BrandenConnors/it-dept-pumpkin-cart/Parts/02_Chassis_Mounts/README.md

# 02 Chassis Mounts

Use the master [build guide](../../Documentation/Build_Guide.pdf). STL files use millimeters and retain their supplied print orientations. One STL is one piece; print the quantities below.

| STL | Quantity | Status |
|---|---:|---|
| 16A_front_end_adapter_TRIAL.stl | As needed | Optional alternative |
| 16B_rear_end_adapter_TRIAL.stl | 1 | As fitted |
| 17_mount_shim_12mm_print_4.stl | 4 | As fitted |
| 17B_mount_shim_2mm_OPTIONAL.stl | As needed | As fitted |

## Fit and printing notes

- **16A_front_end_adapter_TRIAL.stl:** Front adapter omitted in Branden's assembled configuration. Retained as an alternate mount option.
- **16B_rear_end_adapter_TRIAL.stl:** Retain your successful spacer stack and mounting configuration. 8 mm trial adapter; rear chassis slots nominal 86 mm centers. Fit template 00D first. Chassis screw thread/length not yet confirmed.
- **17_mount_shim_12mm_print_4.stl:** Retain your successful spacer stack and mounting configuration. 12 mm provisional spacer between adapter and floor underside. Adjust height only after checking clearances under load.
- **17B_mount_shim_2mm_OPTIONAL.stl:** Retain your successful spacer stack and mounting configuration. Optional 2 mm adjustment washer. Print only as required; use equal stacks left/right. Longer bolts may be needed.
