BrandenConnors/it-dept-pumpkin-cart/Stencils/Pumpkin_Cutting_Stencils.pdf

IT DEPT PUMPKIN CART / CURRENT STENCILS

# Pumpkin pieces: complete cutting set

Release 1.0.0 | R2 bed/roof + HF2 hood/fenders + SR1 side runners

Print pages 2-8 at 100%, then fit paper to the assembled cart first.
Trace on the inner flesh face. Begin with 8-10 mm or more at spike contacts. The 6 mm spikes must engage flesh without breaking through the outer rind. Do not press pumpkin on until fasteners are tightened and clearances checked.
2 | Bed sides | x2 | 132 x 47.6 mm
3 | Rear bed | x1 | 154 x 47.6 mm; trim to side thickness
4 | Roof | x1 | 158 x 168.4 mm developed surface
5 | Cab skirts | x2 | 120 x 34 mm; reverse for other side
6 | Rear wheel arches | x2 | 116 x 55 mm, R44 opening
7 | Front fenders | x2 | 100 x 34 mm contact footprints
8 | Hollow hood | x1 | Fitting reference; exterior hand-trimmed

Fit bed sides, rear panel, skirts and arches, then hood/fenders; roof last. For a one-piece hood plus fenders, use page 7 to mark the two pad contacts on your shell. Their spacing depends on your final slider settings.
Page 8 deliberately does not prescribe a 30 mm-high cap or fixed cavity.
The old low-hood template is superseded and is not included.
Check the complete tire sweep with the pumpkin fitted, then test at low speed.

Print Actual Size / 100%. Never Fit or Shrink. Verify the ruler.

0 | 10 | 20 | 30 | 40 | 50 | 60 | 70 | 80 | 90 | 100
100 mm calibration ruler. Crosses mark flesh contact; do not drill holes.
IT DEPT PUMPKIN CART / CURRENT STENCILS | 1 / 8

## A + B / Bed side panels

For the R2 50 mm-tall bed. Spike marks face the PLA wall.

IT DEPT PUMPKIN CART / R2 | 2 / 5

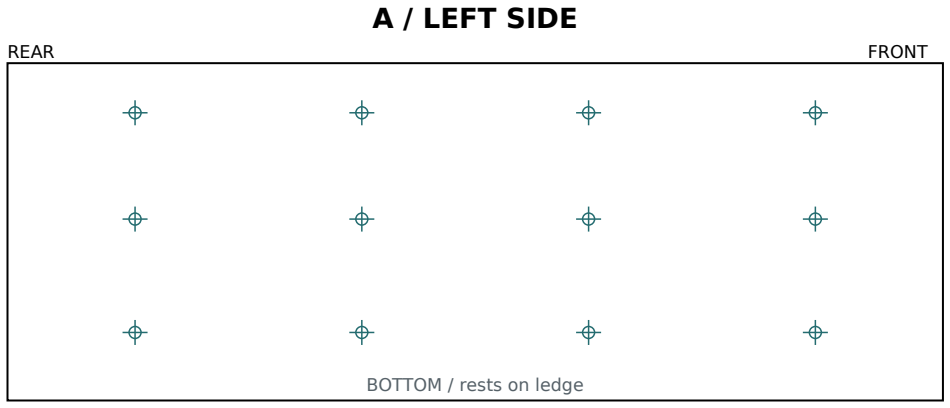
[picture p2: figure]
A / LEFT SIDE; REAR; FRONT; BOTTOM / rests on ledge

132 x 47.6 mm - cut 1

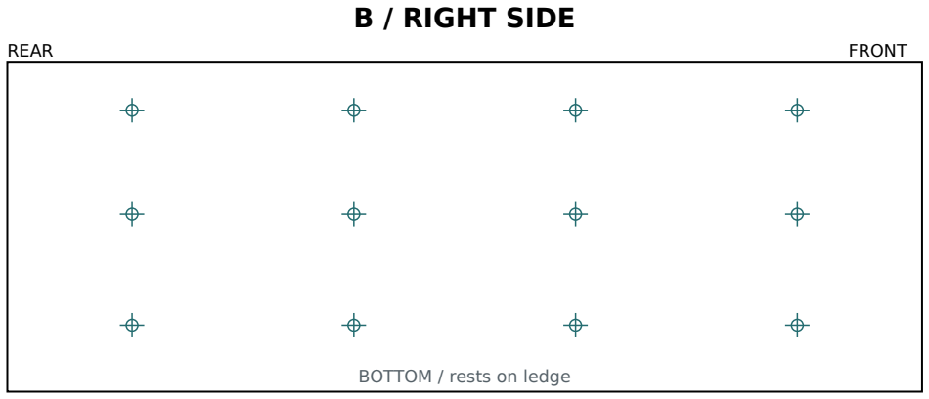
[picture p3: figure]
B / RIGHT SIDE; REAR; FRONT; BOTTOM / rests on ledge

132 x 47.6 mm - cut 1

Cut one of each. Both sides use the same outline and spike pattern.

The 47.6 mm height runs from the ledge top to the 50 mm bed rim.

Mark the flesh face only. Press onto spikes without pre-punching holes.

Trim the ends locally if the curved bed corners prevent a close fit.

PRINT ACTUAL SIZE / 100% | US LETTER | Do not use Fit or Shrink.

Millimeters: verify 0-100 measures exactly 100 mm.

1 inch wide

Solid = cut edge. Cross = spike contact mark; do not punch holes.

IT DEPT PUMPKIN CART / CURRENT STENCILS | 2 / 8

## C / Rear bed panel

Cut oversize for 10 mm side panels, then trim after fitting the sides.

IT DEPT PUMPKIN CART / R2 | 3 / 5

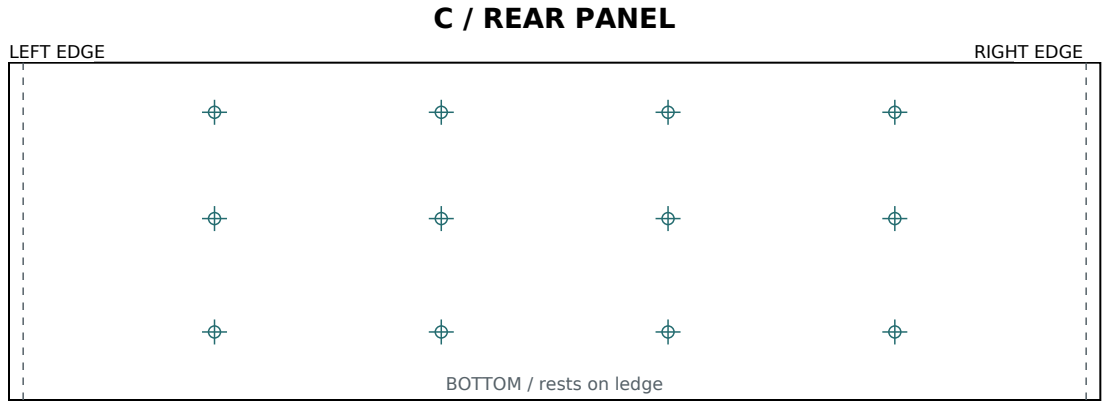
[picture p4: figure]
C / REAR PANEL; REAR; FRONT; BOTTOM / rests on ledge; LEFT EDGE; RIGHT EDGE

154 x 47.6 mm - cut 1

The rear panel covers the exposed ends of the two side panels.

Starting width = 134 mm bed width + twice your side-panel thickness.

Keep the rear panel centered so its spike marks remain aligned.

Side-panel thickness | Rear width | Trim from each edge
10 mm | 154 mm | 0 mm
9 mm | 152 mm | 1 mm
8 mm | 150 mm | 2 mm

Dashed lines show the 150 mm width for 8 mm side panels.

Use your fitted paper pattern to confirm the corner joints before carving.

PRINT ACTUAL SIZE / 100% | US LETTER | Do not use Fit or Shrink.

Millimeters: verify 0-100 measures exactly 100 mm.

1 inch wide

Solid = cut edge. Cross = spike contact mark; do not punch holes.

IT DEPT PUMPKIN CART / CURRENT STENCILS | 3 / 8

## D / Roof panel

Full-size unfolded contact surface. Crosses locate the 12 roof spikes.

IT DEPT PUMPKIN CART / R2 | 4 / 5

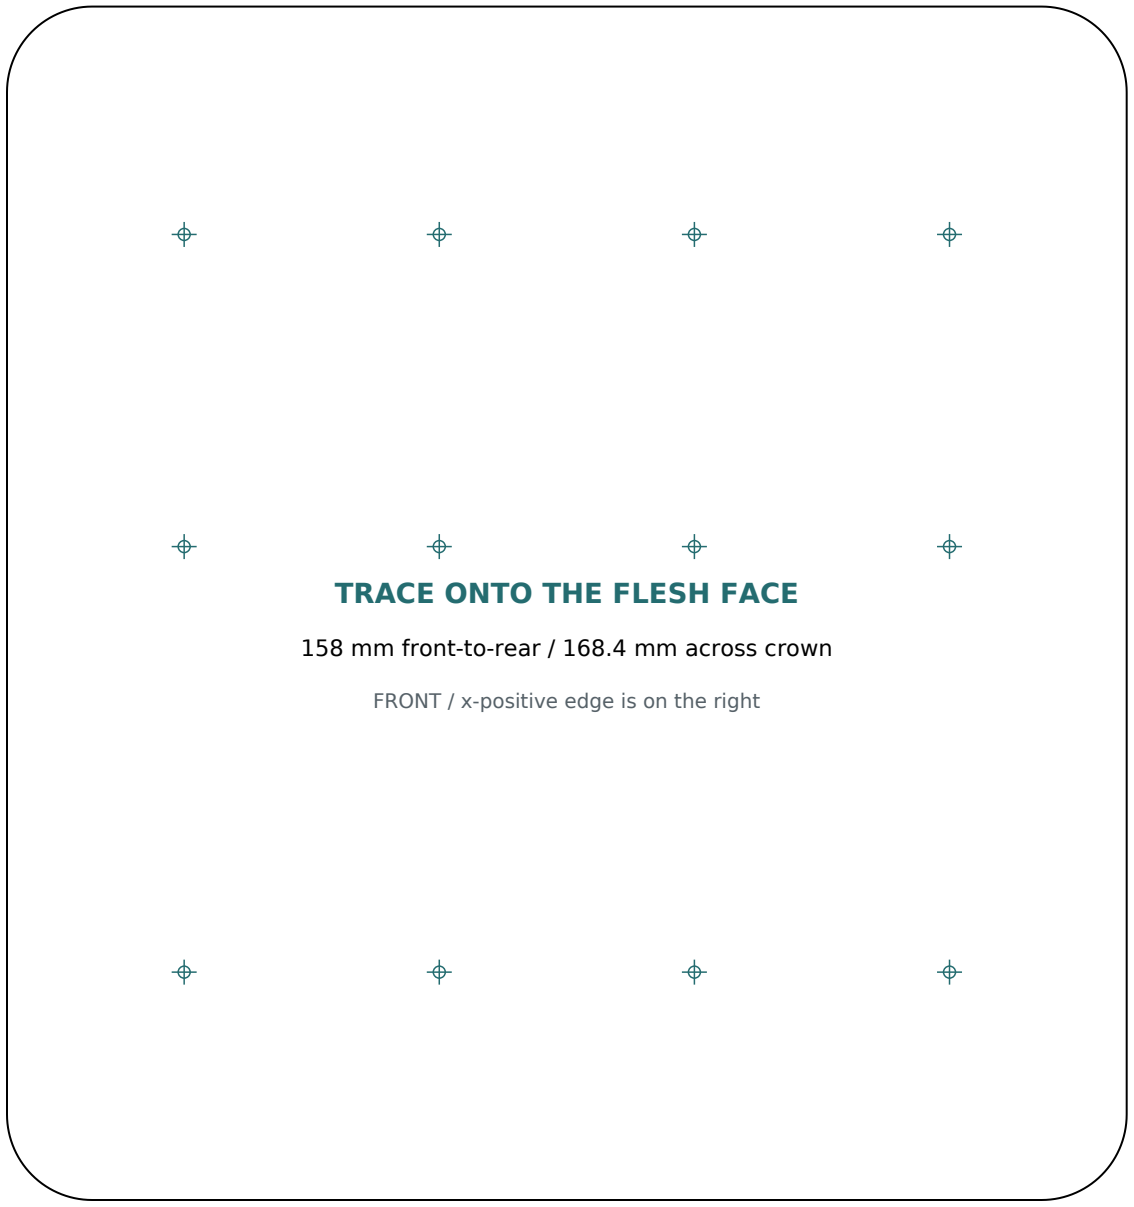
[picture p5: figure]
TRACE ONTO THE FLESH FACE; FRONT / x-positive edge is on the right

158 mm front-to-rear / 168.4 mm across crown

Fit across the shallow crown; the outline includes its curved surface length.

Keep the panel removable. Trim the paper outline first if your rind will not conform.

PRINT ACTUAL SIZE / 100% | US LETTER | Do not use Fit or Shrink.

Millimeters: verify 0-100 measures exactly 100 mm.

1 inch wide

Solid = cut edge. Cross = spike contact mark; do not punch holes.

IT DEPT PUMPKIN CART / CURRENT STENCILS | 4 / 8

IT DEPT PUMPKIN CART / SIDE RUNNERS SR1 | 5 / 6

# Cab pumpkin cutting template

Full size. Cut two pumpkin pieces; reverse the pattern for the opposite side.

REAR | FRONT

100 mm - print Actual Size / 100%, never Fit to Page

Solid outline is the backing footprint: 120 x 34 mm.

Red crosses mark spike locations. They are NOT drilled mounting holes.

Begin with roughly 8-10 mm of pumpkin flesh at the spike locations.

The spikes extend 6 mm into the flesh; thicker pieces can be used.

Rest the bottom edge on the ledge and press evenly onto the spikes.

Carve small access recesses over the panel screws if needed.

Trim the outside silhouette to blend into the adjoining rear arch.

Fit both pieces to the actual vehicle before making any extra overhang.

Prototype: verify actual wheel travel, pumpkin grip and clamp security before driving.

IT DEPT PUMPKIN CART / CURRENT STENCILS | 5 / 8

IT DEPT PUMPKIN CART / SIDE RUNNERS SR1 | 6 / 6

# Rear arch pumpkin cutting template

Full size. The wheel opening is provisional: check articulation before carving.

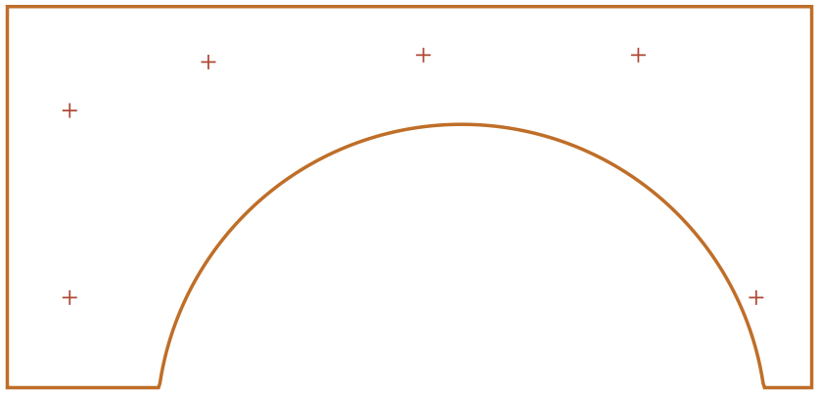
[picture p6: figure]

REAR | FRONT

100 mm - print Actual Size / 100%, never Fit to Page

Outline: 116 x 55 mm, with a 44 mm-radius opening centered 65.5 mm

from the rear edge and 6 mm below the bottom edge of the bounding box.

Cut two pumpkin pieces; reverse the pattern for the opposite side.

The ledges above the arch need shallow seating notches in the inner flesh.

Mark these directly from the printed panel before pressing onto the spikes.

Keep flesh clear of the whole tire sweep, not just the tire at rest.

If the backing itself touches a tire or linkage, do not drive the cart.

Readjust or revise the support first; carving pumpkin alone cannot fix that.

Prototype: verify actual wheel travel, pumpkin grip and clamp security before driving.

IT DEPT PUMPKIN CART / CURRENT STENCILS | 6 / 8

IT DEPT PUMPKIN CART / CURRENT STENCILS

# Front fenders / cut two

Full-size pad footprints. Use as contact patterns for a single hood/fender shell.

REAR / long end | FRONT
100 x 34 mm | six spike contacts | cut one
REAR / long end | FRONT
100 x 34 mm | six spike contacts | cut one

The outline matches the printed pad, not the final bodywork silhouette.
Round and trim each piece to blend with the hood and adjacent cab skirt. Seat the flesh on the pad before assessing tire clearance or adding overhang. Keep screw access available until both pad positions are final.
For one shell, transfer these marks after adjusting each pad to the shell.

Print Actual Size / 100%. Never Fit or Shrink. Verify the ruler.

100 mm calibration ruler. Crosses mark flesh contact; do not drill holes.

IT DEPT PUMPKIN CART / CURRENT STENCILS | 7 / 8

IT DEPT PUMPKIN CART / CURRENT STENCILS

# HF2 hood / full-size fitting reference

Top view: NOT a fixed exterior cut line. Match the hollow shell to the raised bars.

FRONT (+X) is to the RIGHT

Solid: 76 x 88 mm carrier reference. Dashed: 48 x 64 mm tower envelope.

Orange bars: six hood contact points. Their height adjusts independently. Seats adjust 40-60 mm above carrier bottom; spike tips are 46-66 mm above.
1. Fit paper around your hollow pumpkin shell; mark its desired outer silhouette.
2. Allow cavity clearance around the dashed envelope and all screw heads.
3. Lower bars; trial-fit shell. Raise seats to meet the inner flesh without forcing.
4. Remove shell, tighten sliders, then press onto the six spikes.
5. Join to separate fenders, or transfer pad contacts to your one-piece shell. Retain 8-10 mm or more of flesh at contacts. Carve gradually and recheck. A hollow shell is three-dimensional: this top view cannot define its final cut.

Print Actual Size / 100%. Never Fit or Shrink. Verify the ruler.

100 mm calibration ruler. Crosses mark flesh contact; do not drill holes.

IT DEPT PUMPKIN CART / CURRENT STENCILS | 8 / 8
