BrandenConnors/it-dept-pumpkin-cart/Documentation/GITHUB_PUBLISH_PLAN.md

# GitHub publication plan

Prepared repository name: `it-dept-pumpkin-cart` (proposed; not created).
Prepared first release/tag: `v1.0.0`.

1. Connect GitHub and choose the owning account or existing repository.
2. Begin with a private repository unless Branden chooses public visibility.
3. Put the CONTENTS of this package at repository root: README, Parts, Documentation, Stencils, Source, and inventories.
4. Review the README, source attribution and license choice before making the repository public. No license grant has been added automatically.
5. Commit the packaged files and tag the initial release `v1.0.0` after reviewing the repository.
6. Attach the complete ZIP to the GitHub release for convenient downloading; do not commit the ZIP inside the repository as a duplicate of all files.
7. Future physical changes should receive a new release, updated guide/stencils and a changelog describing what needs reprinting.

The package is ready for this upload. Packaging does not itself create a repository or publish any files. The archive contains project files, not user photographs or account credentials.
