BrandenConnors/it-dept-pumpkin-cart/Documentation/Images/hf2_insert_map.png

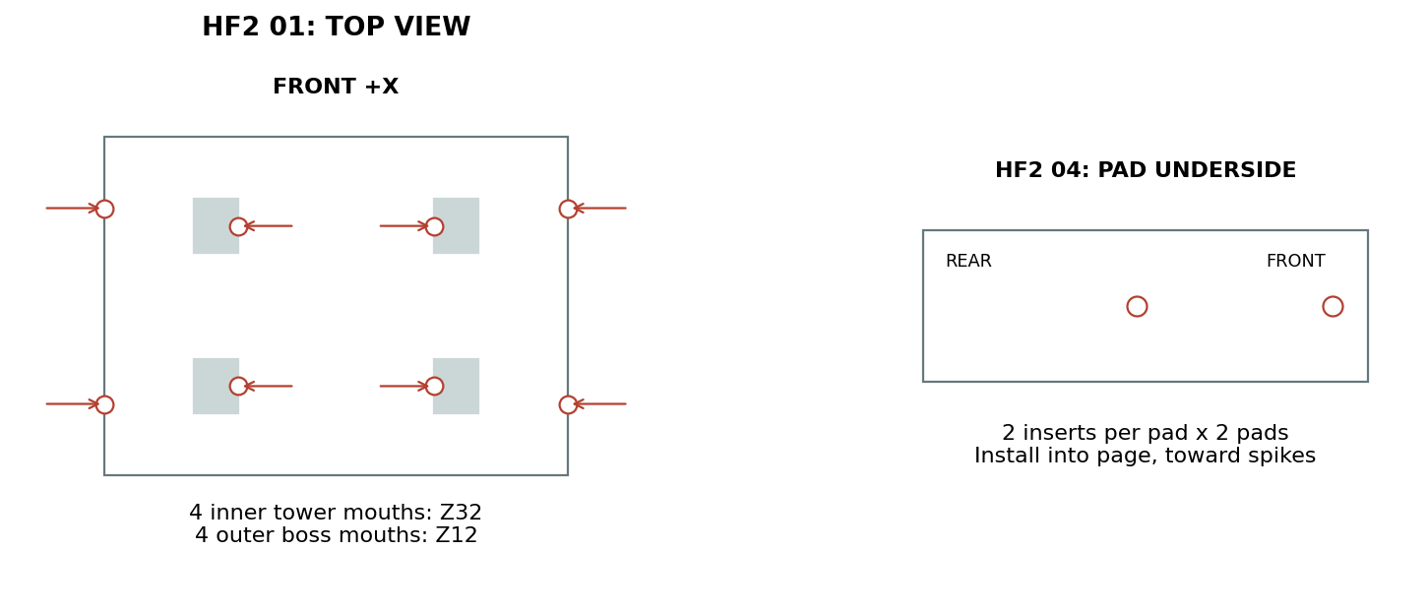
Documentation/Images/hf2_insert_map.png
