BrandenConnors/it-dept-pumpkin-cart/Documentation/Images/sr1_insert_map.png

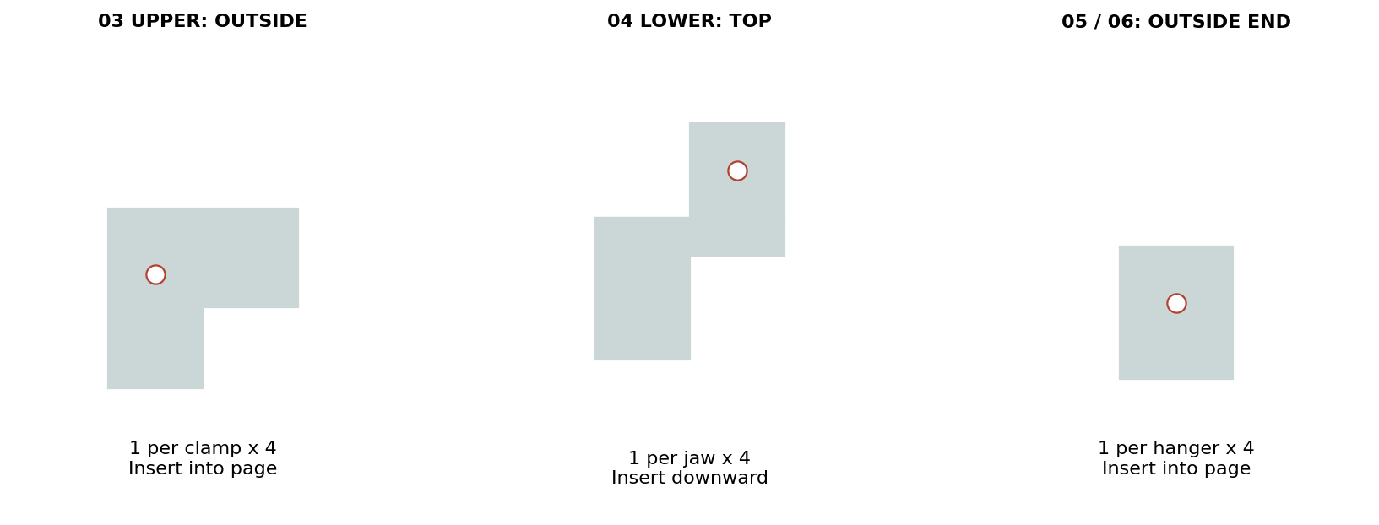
Documentation/Images/sr1_insert_map.png
