BrandenConnors/it-dept-pumpkin-cart/Documentation/Insert_Maps/insert_06_seat_pedestal.png

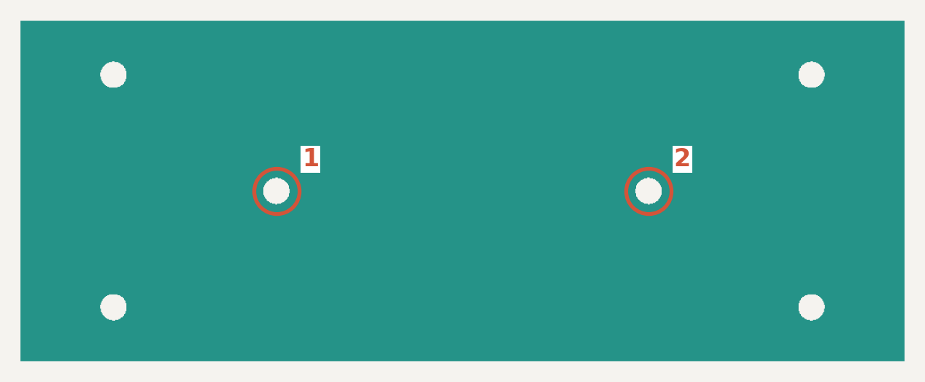
Documentation/Insert_Maps/insert_06_seat_pedestal.png
