BrandenConnors/it-dept-pumpkin-cart/Documentation/Insert_Maps/insert_16A_front_end_adapter_TRIAL.png

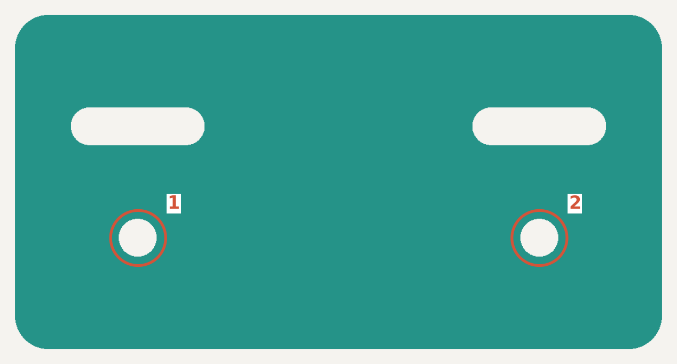
Documentation/Insert_Maps/insert_16A_front_end_adapter_TRIAL.png
