BrandenConnors/it-dept-pumpkin-cart/Documentation/Insert_Maps/insert_16B_rear_end_adapter_TRIAL.png

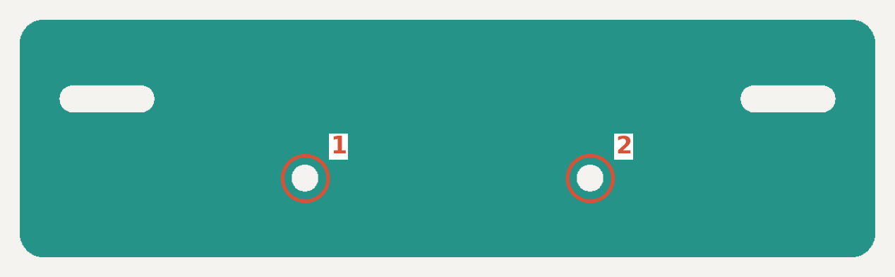
Documentation/Insert_Maps/insert_16B_rear_end_adapter_TRIAL.png
