BrandenConnors/it-dept-pumpkin-cart/Documentation/Insert_Maps/insert_bench_-1.png

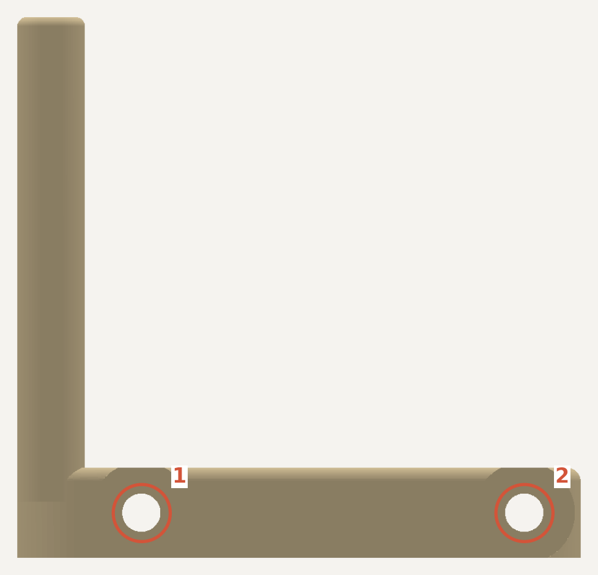
Documentation/Insert_Maps/insert_bench_-1.png
