BrandenConnors/it-dept-pumpkin-cart/Documentation/Insert_Maps/insert_dash.png

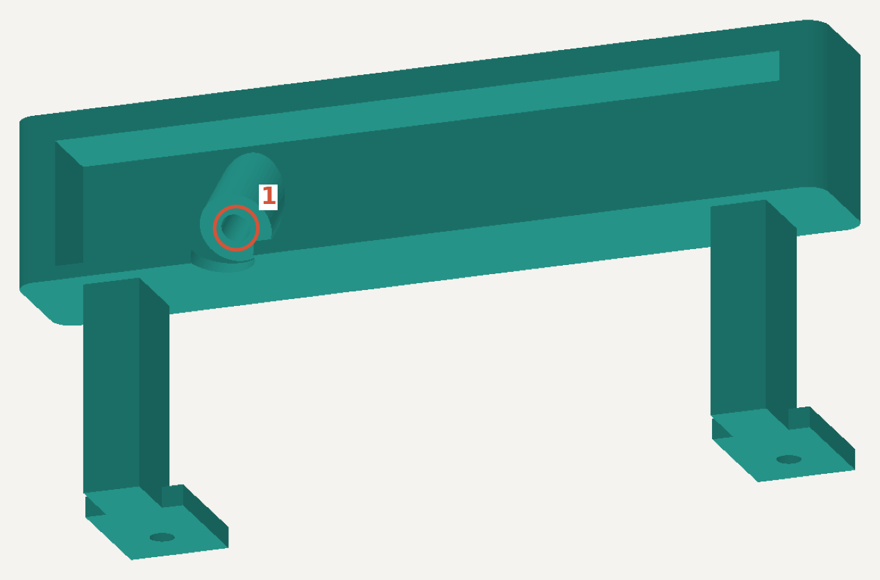
Documentation/Insert_Maps/insert_dash.png
