BrandenConnors/it-dept-pumpkin-cart/Documentation/Insert_Maps/insert_dash_close.png

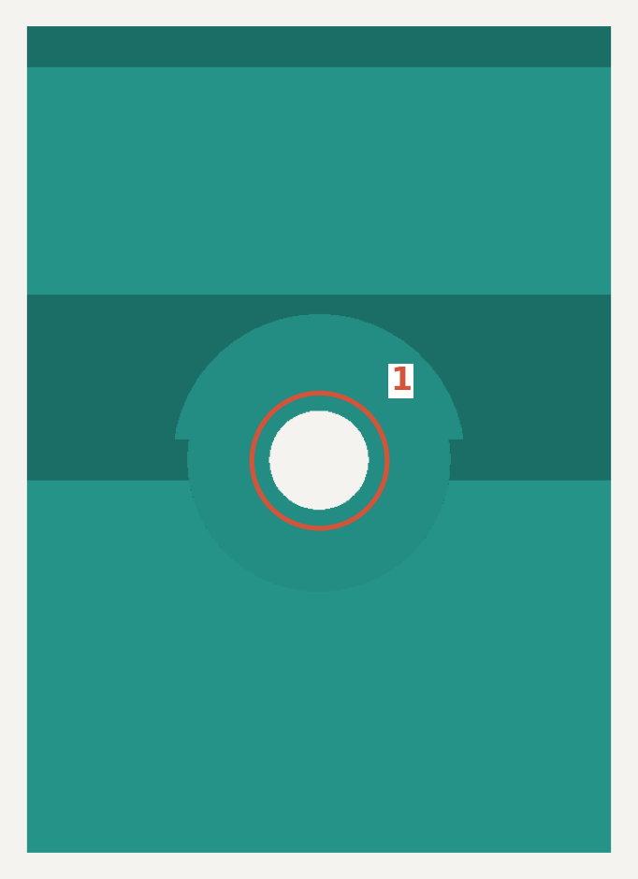
Documentation/Insert_Maps/insert_dash_close.png
