BrandenConnors/it-dept-pumpkin-cart/Documentation/Insert_Maps/insert_floor_front.png

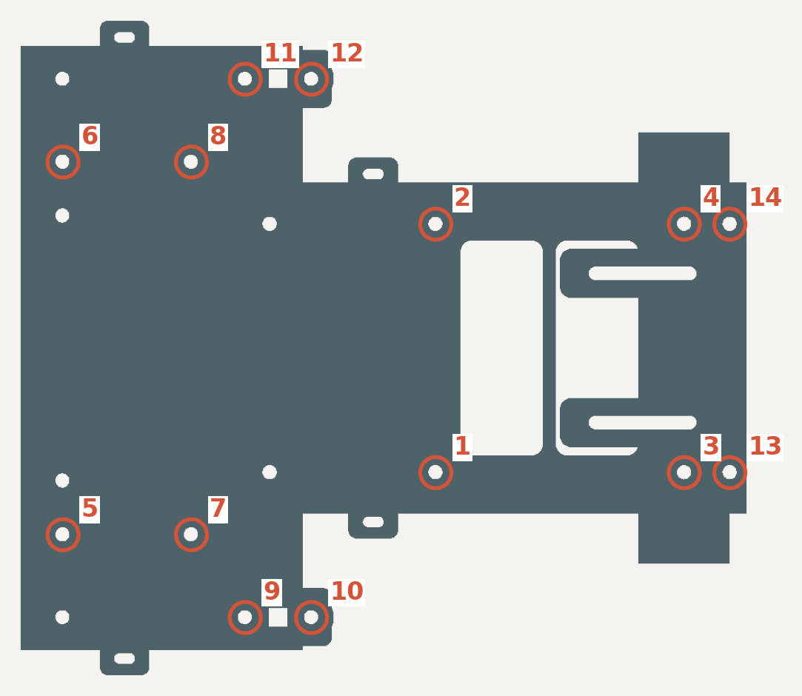
Documentation/Insert_Maps/insert_floor_front.png
