BrandenConnors/it-dept-pumpkin-cart/Documentation/Insert_Maps/insert_floor_rear.png

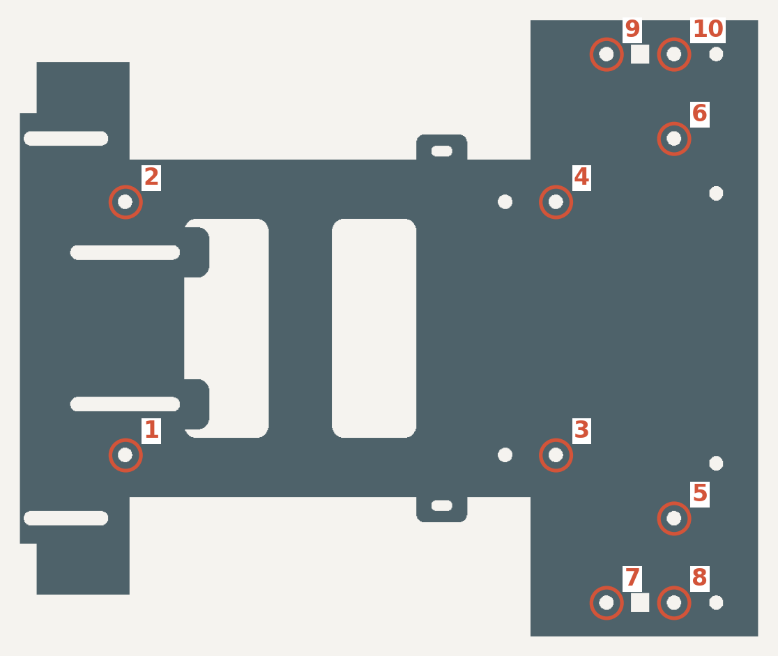
Documentation/Insert_Maps/insert_floor_rear.png
