BrandenConnors/it-dept-pumpkin-cart/Documentation/Insert_Maps/insert_post_1.png

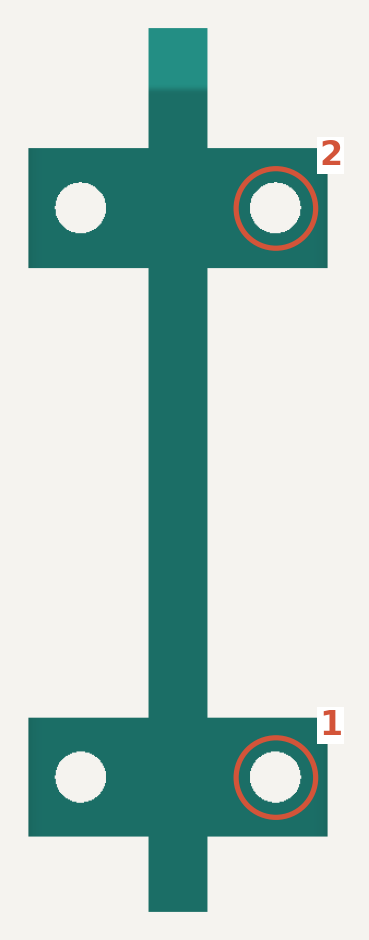
Documentation/Insert_Maps/insert_post_1.png
