BrandenConnors/it-dept-pumpkin-cart/Documentation/Insert_Maps/insert_roof_under.png

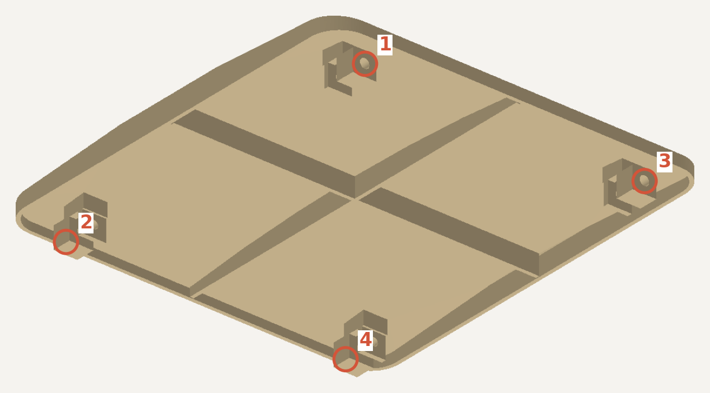
Documentation/Insert_Maps/insert_roof_under.png
