BrandenConnors/it-dept-pumpkin-cart/Parts/05_Bed/README.md

# 05 Bed

Use the master [build guide](../../Documentation/Build_Guide.pdf). STL files use millimeters and retain their supplied print orientations. One STL is one piece; print the quantities below.

| STL | Quantity | Status |
|---|---:|---|
| 04_bed_50mm_sharp_6mm_R2.stl | 1 | Required |
| 07_bed_spacer_16mm_print_4.stl | 4 | Required |

## Fit and printing notes

Current stack: floor -> 16 mm spacer -> 4 mm SR1 hanger -> R2 bed. Hangers are in `07_Side_Runners`. Bed floor down; inspect supports for outward-facing spikes.
