BrandenConnors/it-dept-pumpkin-cart/Parts/06_Hood_Fenders/README.md

# 06 Hood Fenders

Use the master [build guide](../../Documentation/Build_Guide.pdf). STL files use millimeters and retain their supplied print orientations. One STL is one piece; print the quantities below.

| STL | Quantity | Status |
|---|---:|---|
| 15_hood_spacer_9mm_print_4.stl | 4 | Required |
| 01_spiked_hood_carrier_HF2.stl | 1 | Required |
| 02_fender_riser_positive_Y_HF2.stl | 1 | Required |
| 03_fender_riser_negative_Y_HF2.stl | 1 | Required |
| 04_fender_pad_print_2_HF2.stl | 2 | Required |
| 05_raised_spike_bar_print_2_HF2.stl | 2 | Required |

## Fit and printing notes

- **15_hood_spacer_9mm_print_4.stl:** Prototype; verify fit before final printing

HF2 carrier base down; sliding bars supplied side-down and need supports beneath sideways spikes. Risers are supplied inner-face-down; pads flat underside down. Bars carry the hollow hood above the towers.
