BrandenConnors/it-dept-pumpkin-cart/Parts/07_Side_Runners/README.md

# 07 Side Runners

Use the master [build guide](../../Documentation/Build_Guide.pdf). STL files use millimeters and retain their supplied print orientations. One STL is one piece; print the quantities below.

| STL | Quantity | Status |
|---|---:|---|
| 01_cab_skirt_left.stl | 1 | Required |
| 01_cab_skirt_right.stl | 1 | Required |
| 02_rear_arch_left.stl | 1 | Required |
| 02_rear_arch_right.stl | 1 | Required |
| 03_cab_upper_clamp_left.stl | 2 | Required |
| 03_cab_upper_clamp_right.stl | 2 | Required |
| 04_cab_lower_jaw_left.stl | 2 | Required |
| 04_cab_lower_jaw_right.stl | 2 | Required |
| 05_rear_bed_hanger_left.stl | 1 | Required |
| 05_rear_bed_hanger_right.stl | 1 | Required |
| 06_forward_bed_hanger_left.stl | 1 | Required |
| 06_forward_bed_hanger_right.stl | 1 | Required |
| 08_offset_spacer_5mm_optional.stl | As needed | Optional offset |
| 09_offset_spacer_10mm_optional.stl | As needed | Optional offset |

## Fit and printing notes

- **08_offset_spacer_5mm_optional.stl:** Offset spacers: two of equal thickness per panel; choose 5 OR 10 mm.
- **09_offset_spacer_10mm_optional.stl:** Offset spacers: two of equal thickness per panel; choose 5 OR 10 mm.

Cab upper clamps and forward bed hangers need support under overhangs. Backings print flat with spikes up. Four 16 mm bed spacers are in `05_Bed`. No additional floor holes are needed.
