BrandenConnors/it-dept-pumpkin-cart/Documentation/HARDWARE.csv

item | quantity_both_adapters | quantity_front_adapter_omitted | notes
M3x8 screws | 14 | 14 | Nominal under-head length
M3x10 screws | 26 | 26 | Innermost side-panel setting
M3x16 screws | 22 | 22 | Nominal
M3x20 screws | 2 | 2 | Nominal
M3x25 screws | 4 | 2 | Adapter joints only
M3x30 screws | 8 | 8 | Nominal
M3x35 screws | 1 | 1 | Steering column
M3 heat-set inserts | 77 | 75 | Test actual OD and length before fitting
M3 washers | 77 | 75 | One per head where flat; confirm thickness
Truck/direct-mount hardware |  |  | Retain fitted thread type and usable length; additional to totals
Clear windshield sheet |  |  | Nominal 0.75 mm; cut to actual assembled posts
LEDs and wiring |  |  | Optional; match supply and LED requirements
Zip ties |  |  | As needed for wiring and optional cargo
