BrandenConnors/it-dept-pumpkin-cart/Source/Core_v06/CAD/Core_Only_Reference_Assembly.step

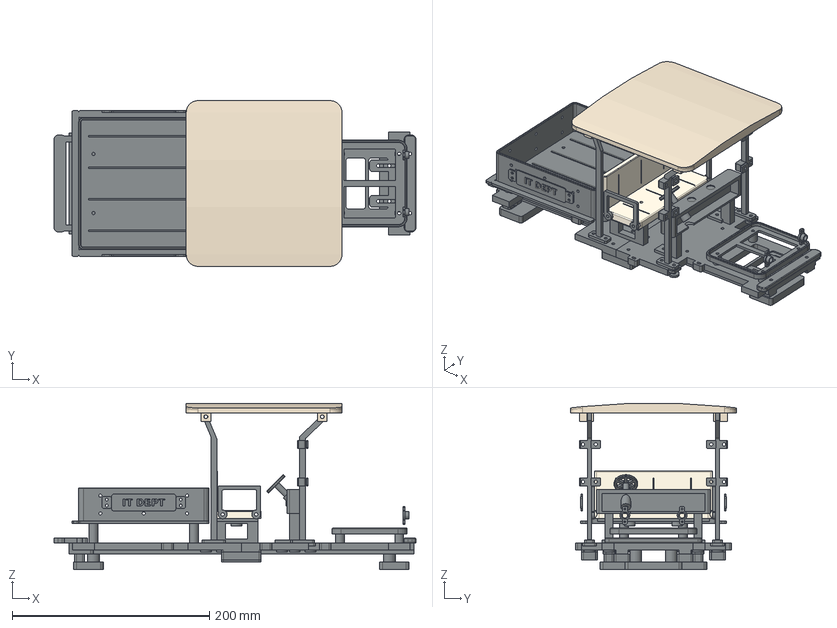
[picture p20: CAD file, 2026-10-19]
Source/Core_v06/CAD/Core_Only_Reference_Assembly.step
367.0 x 168.0 x 168.6 mm
01_floor_rear_0
02_floor_front_1
03_floor_splice_print_4_2
03_floor_splice_print_4_3
03_floor_splice_print_4_4
03_floor_splice_print_4_5
04_fixed_dump_bed_6
05_bed_spacer_20mm_print_4_7
05_bed_spacer_20mm_print_4_8
05_bed_spacer_20mm_print_4_9
05_bed_spacer_20mm_print_4_10
06_seat_pedestal_11
07_bench_seat_12
08_armrest_print_2_13
08_armrest_print_2_14
09_rear_roof_post_print_2_15
10_front_roof_post_print_2_16
09_rear_roof_post_print_2_17
10_front_roof_post_print_2_18
11_roof_19
12_dashboard_20
13_steering_wheel_and_column_21
14_hood_pumpkin_carrier_22
15_hood_spacer_9mm_print_4_23
15_hood_spacer_9mm_print_4_24
15_hood_spacer_9mm_print_4_25
15_hood_spacer_9mm_print_4_26
16B_rear_end_adapter_TRIAL_27
16A_front_end_adapter_TRIAL_28
17_mount_shim_12mm_print_4_29
17_mount_shim_12mm_print_4_30
17_mount_shim_12mm_print_4_31
17_mount_shim_12mm_print_4_32
18_5mm_LED_bezel_print_2_33
18_5mm_LED_bezel_print_2_34
19_IT_DEPT_plaque_print_2_35
19_IT_DEPT_plaque_print_2_36
20A_front_bumper_37
20B_rear_bumper_adjustable_38
20C_rear_bumper_insert_block_print_2_39
20C_rear_bumper_insert_block_print_2_40
21_windshield_plate_print_4_41
21_windshield_plate_print_4_42
21_windshield_plate_print_4_43
21_windshield_plate_print_4_44
