BrandenConnors/it-dept-pumpkin-cart/Source/Hood_Fenders_HF2/CAD/Front_Mount_Assembly_HF2.step

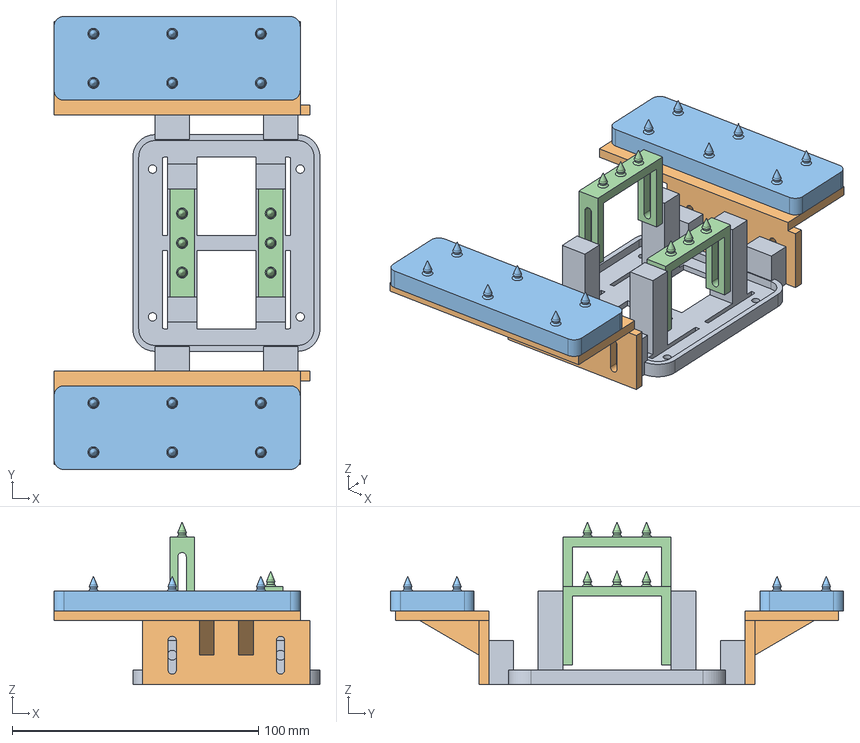
[picture p21: CAD file, 2026-10-19]
Source/Hood_Fenders_HF2/CAD/Front_Mount_Assembly_HF2.step
108.0 x 184.0 x 66.0 mm
carrier
riser_plus
riser_minus
pad_plus
pad_minus
bar_front
bar_rear
