BrandenConnors/it-dept-pumpkin-cart/Source/Side_Runners_SR1/CAD/Side_Runners_Assembly_SR1.step

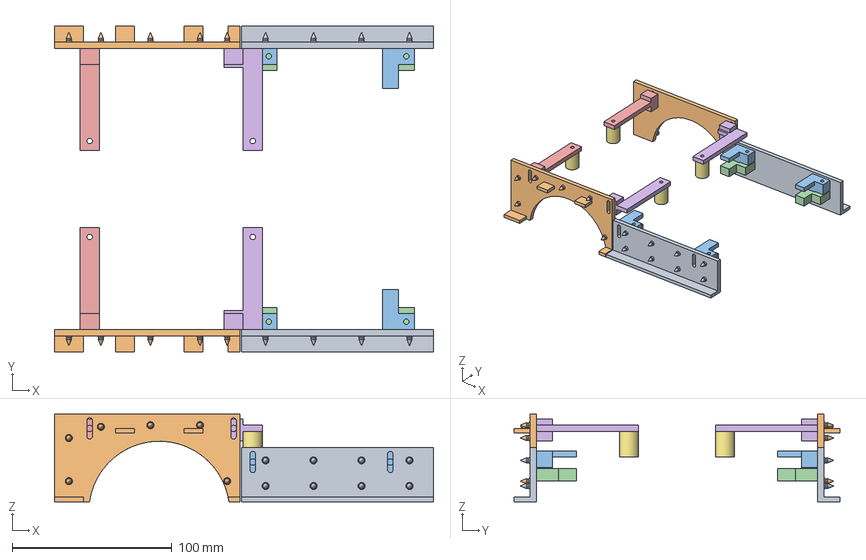
[picture p22: CAD file, 2026-10-19]
Source/Side_Runners_SR1/CAD/Side_Runners_Assembly_SR1.step
237.0 x 204.0 x 55.0 mm
cab_left
arch_left
upper_left-48
lower_left-48
upper_left38
lower_left38
rear_hanger_left
front_hanger_left
bed_spacer_left-150
bed_spacer_left-48
cab_right
arch_right
upper_right-48
lower_right-48
upper_right38
lower_right38
rear_hanger_right
front_hanger_right
bed_spacer_right-150
bed_spacer_right-48
