BrandenConnors/it-dept-pumpkin-cart/Parts/01_Frame/STL/01_floor_rear.stl

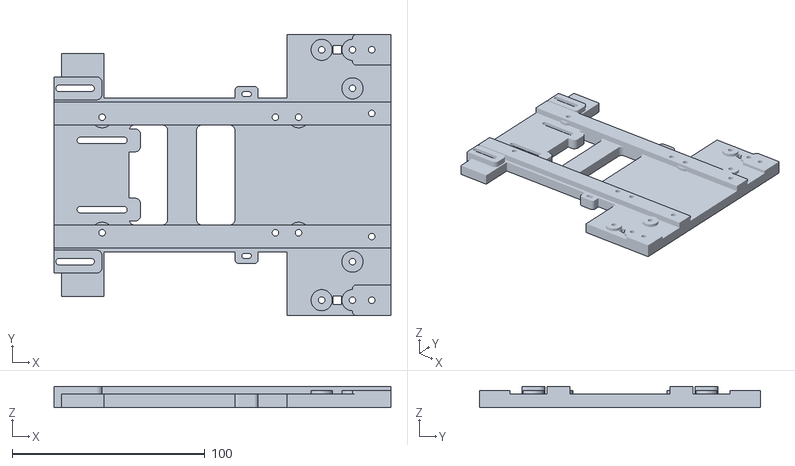
[picture p23: CAD file, 2026-10-19]
Parts/01_Frame/STL/01_floor_rear.stl
175.0 x 146.0 x 11.0
