BrandenConnors/it-dept-pumpkin-cart/Parts/02_Chassis_Mounts/STL/17_mount_shim_12mm_print_4.stl

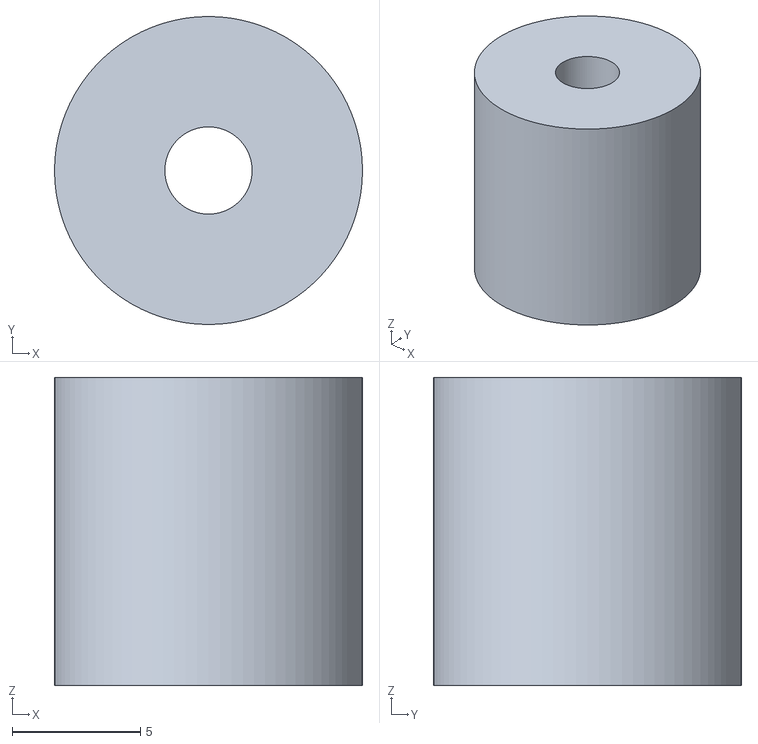
[picture p24: CAD file, 2026-10-19]
Parts/02_Chassis_Mounts/STL/17_mount_shim_12mm_print_4.stl
12.0 x 12.0 x 12.0
