BrandenConnors/it-dept-pumpkin-cart/Parts/03_Cab_Seat_Dashboard/STL/12_dashboard.stl

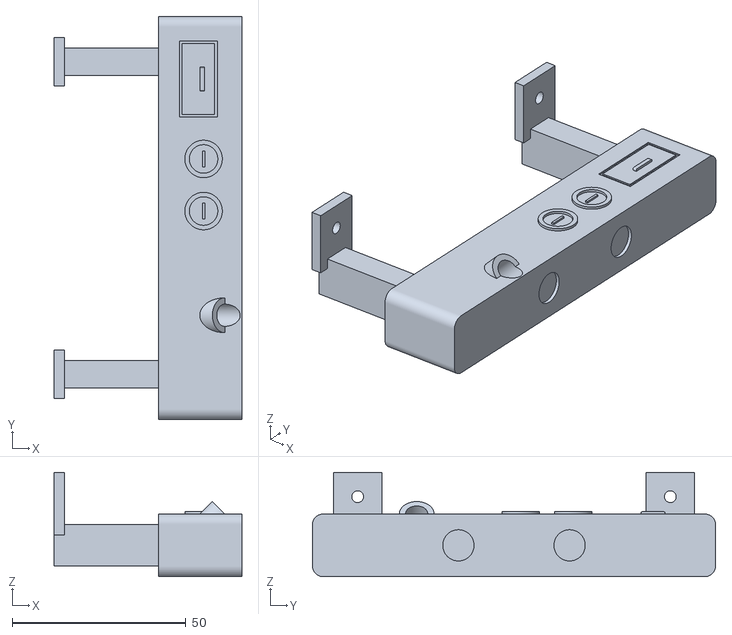
[picture p25: CAD file, 2026-10-19]
Parts/03_Cab_Seat_Dashboard/STL/12_dashboard.stl
54.0 x 116.0 x 30.0
