BrandenConnors/it-dept-pumpkin-cart/Parts/04_Roof_Windshield/STEP/11_roof_sharp_6mm_R2.step

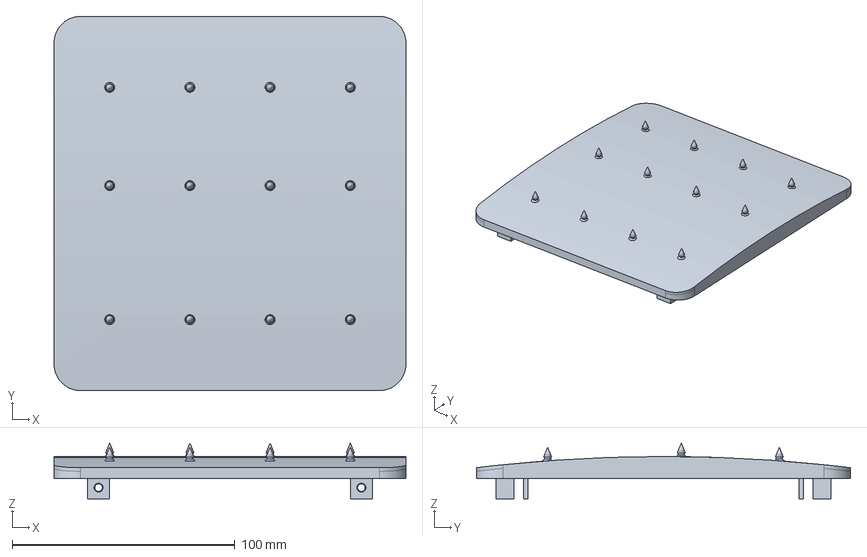
[picture p26: CAD file, 2026-10-19]
Parts/04_Roof_Windshield/STEP/11_roof_sharp_6mm_R2.step
158.0 x 168.0 x 25.0 mm
