BrandenConnors/it-dept-pumpkin-cart/Parts/04_Roof_Windshield/STL/10_front_roof_post_print_2.stl

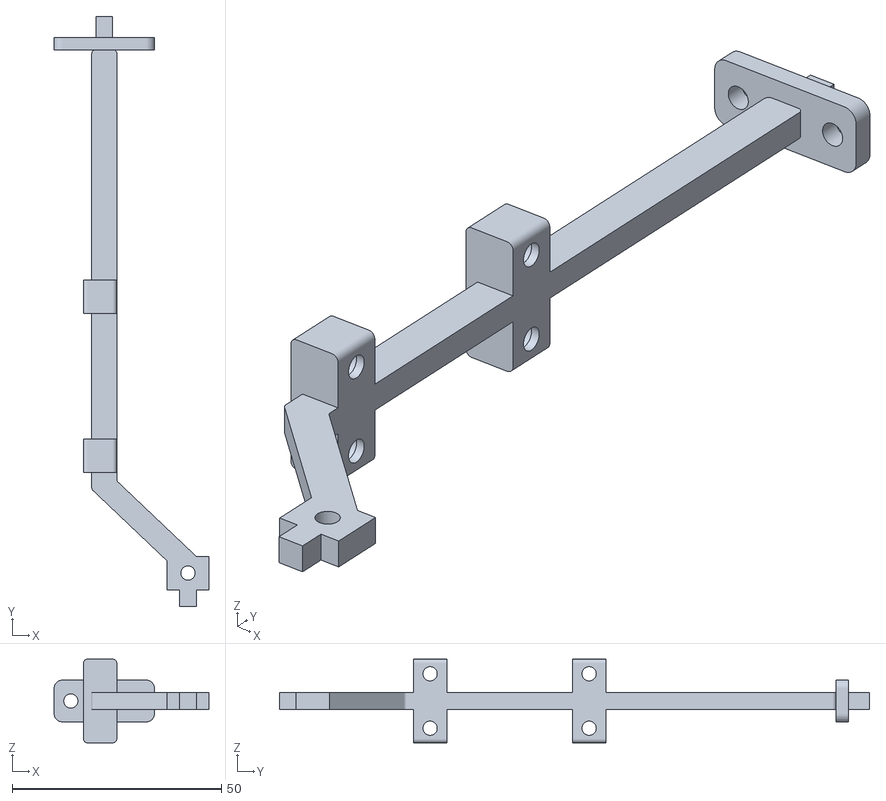
[picture p27: CAD file, 2026-10-19]
Parts/04_Roof_Windshield/STL/10_front_roof_post_print_2.stl
37.0 x 141.0 x 20.0
