BrandenConnors/it-dept-pumpkin-cart/Parts/05_Bed/STEP/04_bed_50mm_sharp_6mm_R2.step

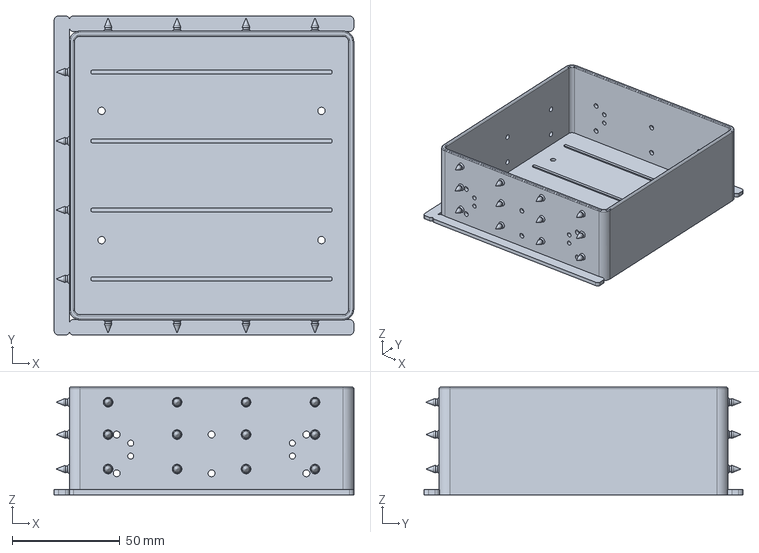
[picture p28: CAD file, 2026-10-19]
Parts/05_Bed/STEP/04_bed_50mm_sharp_6mm_R2.step
139.0 x 148.0 x 50.0 mm
