BrandenConnors/it-dept-pumpkin-cart/Parts/06_Hood_Fenders/STEP/03_fender_riser_negative_Y_HF2.step

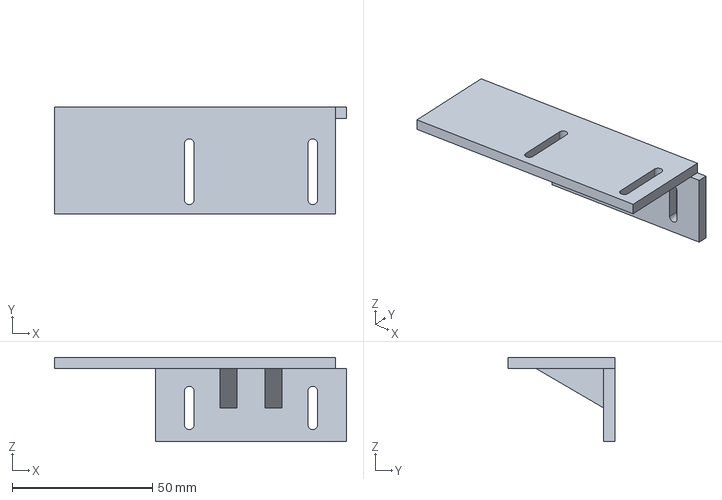
[picture p29: CAD file, 2026-10-19]
Parts/06_Hood_Fenders/STEP/03_fender_riser_negative_Y_HF2.step
104.0 x 38.0 x 30.0 mm
