BrandenConnors/it-dept-pumpkin-cart/Parts/06_Hood_Fenders/STL/15_hood_spacer_9mm_print_4.stl

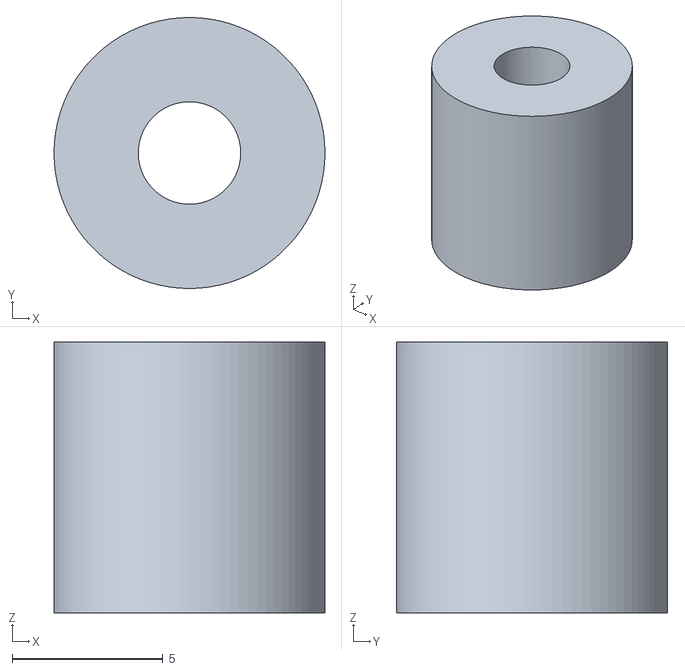
[picture p30: CAD file, 2026-10-19]
Parts/06_Hood_Fenders/STL/15_hood_spacer_9mm_print_4.stl
9.00 x 9.00 x 9.00
