BrandenConnors/it-dept-pumpkin-cart/Parts/07_Side_Runners/STEP/03_cab_upper_clamp_right.step

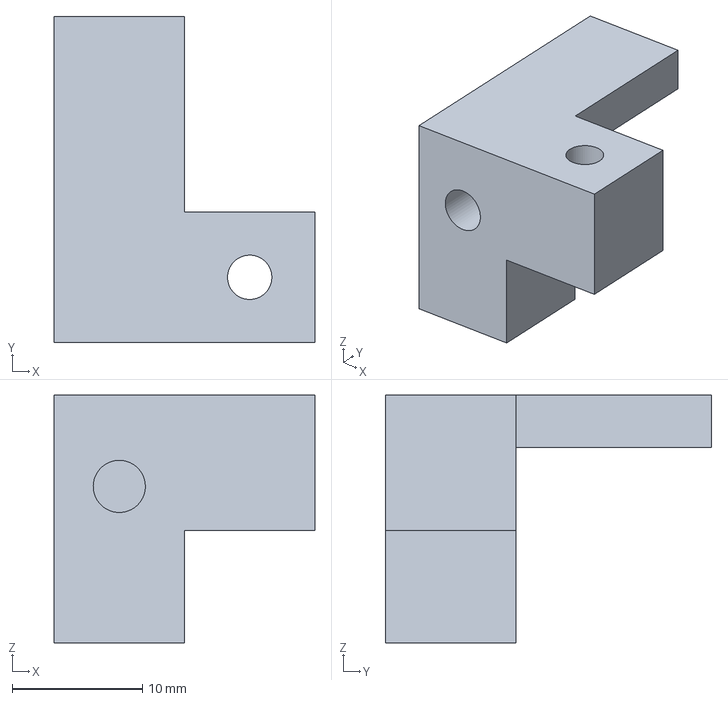
[picture p31: CAD file, 2026-10-19]
Parts/07_Side_Runners/STEP/03_cab_upper_clamp_right.step
20.0 x 25.0 x 19.0 mm
