BrandenConnors/it-dept-pumpkin-cart/Parts/08_Bumpers_Lights_Plaques/STL/20A_front_bumper.stl

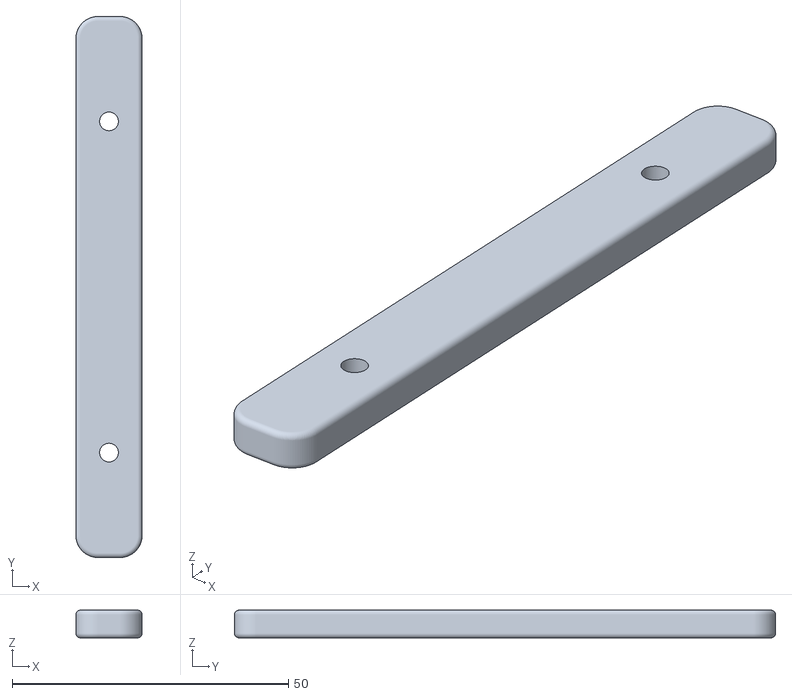
[picture p32: CAD file, 2026-10-19]
Parts/08_Bumpers_Lights_Plaques/STL/20A_front_bumper.stl
12.0 x 98.0 x 5.00
