BrandenConnors/it-dept-pumpkin-cart/Parts/09_Optional_Cargo/STL/07_pc_tower_lid.stl

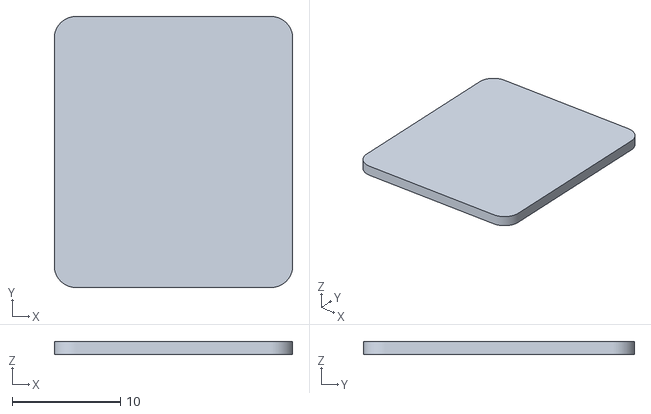
[picture p33: CAD file, 2026-10-19]
Parts/09_Optional_Cargo/STL/07_pc_tower_lid.stl
22.0 x 25.0 x 1.20
