BrandenConnors/it-dept-pumpkin-cart/Parts/10_Fit_Tests/STEP/00_sharp_peg_test_strip_R2.step

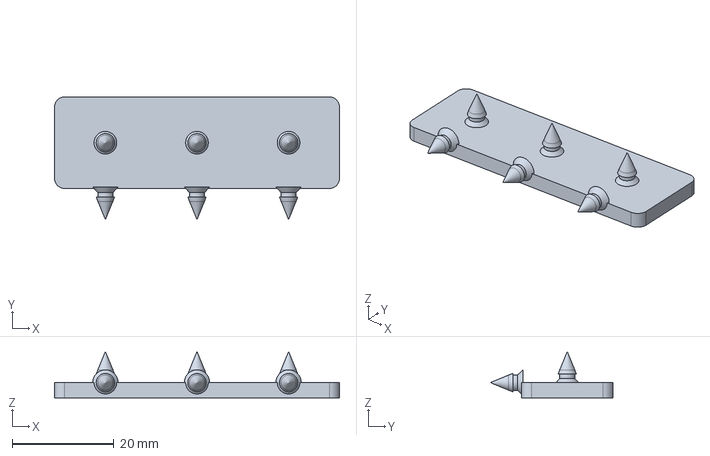
[picture p34: CAD file, 2026-10-19]
Parts/10_Fit_Tests/STEP/00_sharp_peg_test_strip_R2.step
56.0 x 24.0 x 9.00 mm
