BrandenConnors/it-dept-pumpkin-cart/Parts/10_Fit_Tests/STL/00E_M3_insert_fit_test.stl

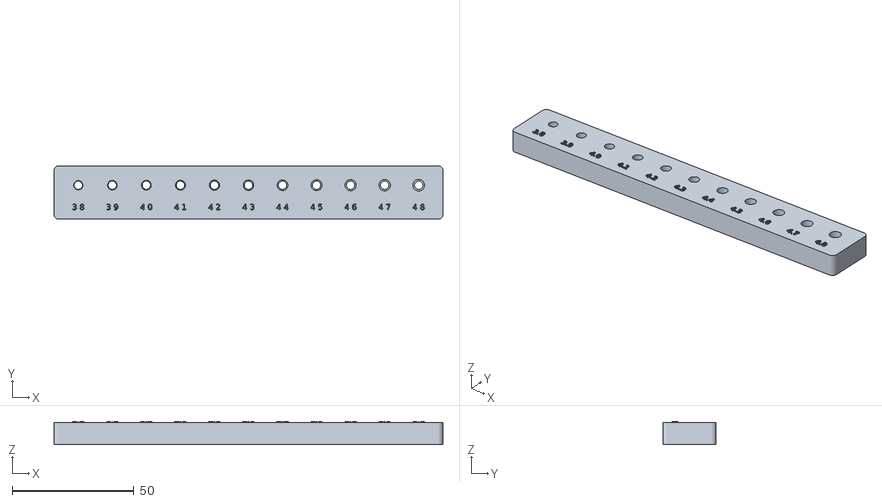
[picture p35: CAD file, 2026-10-19]
Parts/10_Fit_Tests/STL/00E_M3_insert_fit_test.stl
160.0 x 22.0 x 9.50
