BrandenConnors/it-dept-pumpkin-cart/Source/Cargo_v02/CAD/Cargo_Layout.step

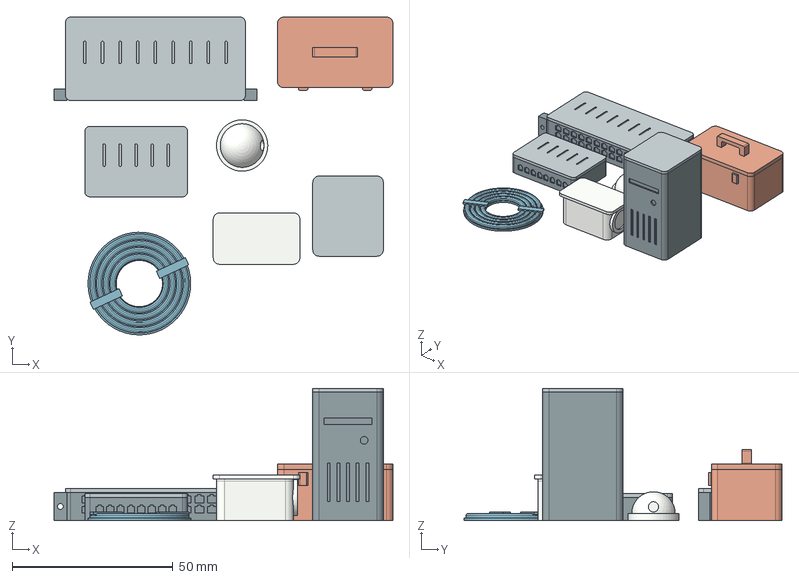
[picture p36: CAD file, 2026-10-19]
Source/Cargo_v02/CAD/Cargo_Layout.step
105.6 x 99.0 x 41.2 mm
24_port_switch_0
24_port_switch_1
8_port_switch_0
8_port_switch_1
Bullet_camera_0
Dome_camera_0
Toolbox_0
Toolbox_1
Cable_coil_0
PC_tower_0
PC_tower_1
