BrandenConnors/it-dept-pumpkin-cart/Parts/01_Frame/STL/02_floor_front.stl

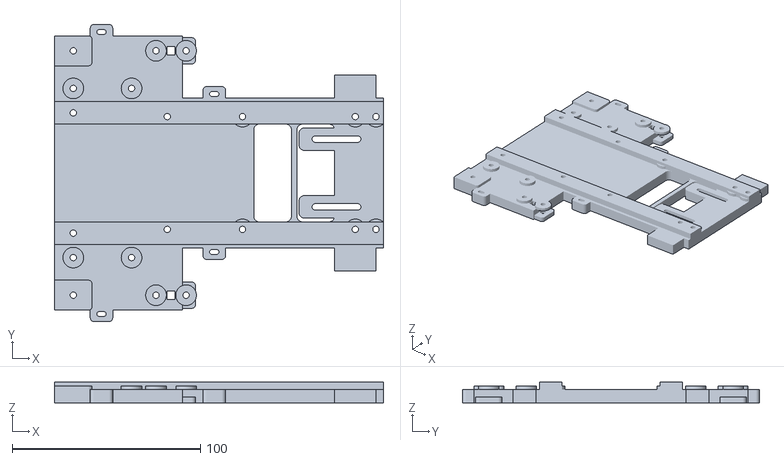
[picture p37: CAD file, 2026-10-19]
Parts/01_Frame/STL/02_floor_front.stl
175.0 x 158.0 x 11.0
