BrandenConnors/it-dept-pumpkin-cart/Parts/02_Chassis_Mounts/STL/16B_rear_end_adapter_TRIAL.stl

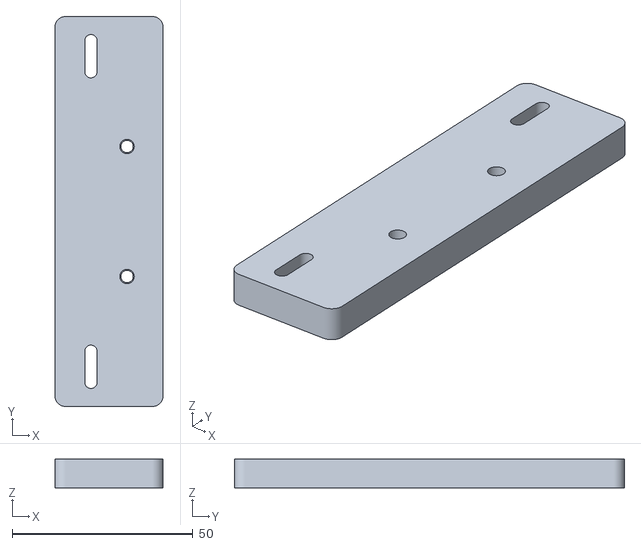
[picture p38: CAD file, 2026-10-19]
Parts/02_Chassis_Mounts/STL/16B_rear_end_adapter_TRIAL.stl
30.0 x 108.0 x 8.00
