BrandenConnors/it-dept-pumpkin-cart/Parts/03_Cab_Seat_Dashboard/STL/06_seat_pedestal.stl

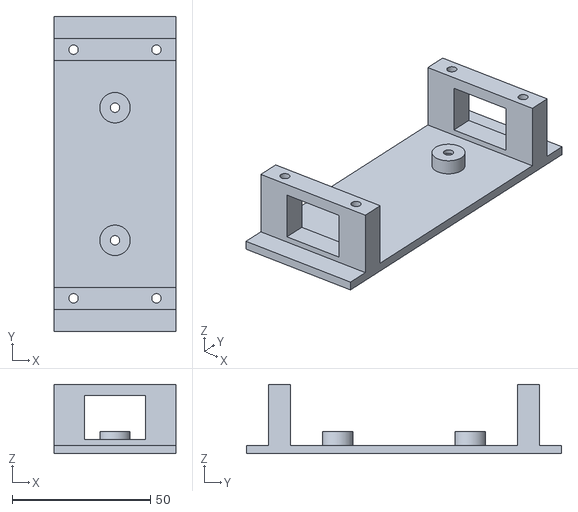
[picture p39: CAD file, 2026-10-19]
Parts/03_Cab_Seat_Dashboard/STL/06_seat_pedestal.stl
44.0 x 114.0 x 25.0
