BrandenConnors/it-dept-pumpkin-cart/Parts/04_Roof_Windshield/STL/09_rear_roof_post_print_2.stl

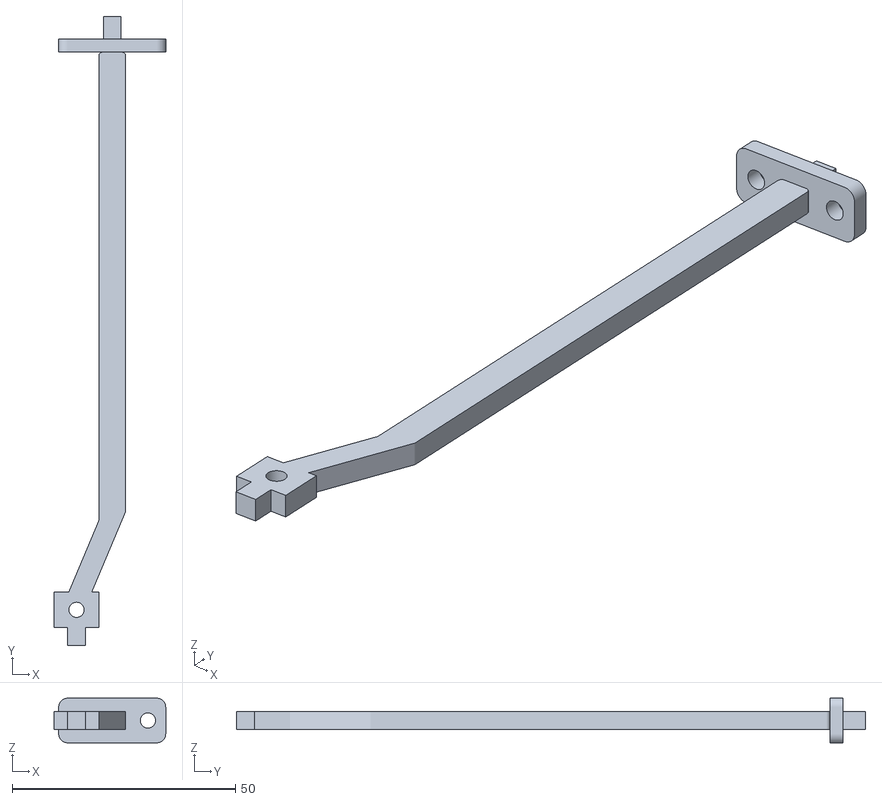
[picture p40: CAD file, 2026-10-19]
Parts/04_Roof_Windshield/STL/09_rear_roof_post_print_2.stl
25.0 x 141.0 x 10.0
