BrandenConnors/it-dept-pumpkin-cart/Parts/05_Bed/STEP/07_bed_spacer_16mm_print_4.step

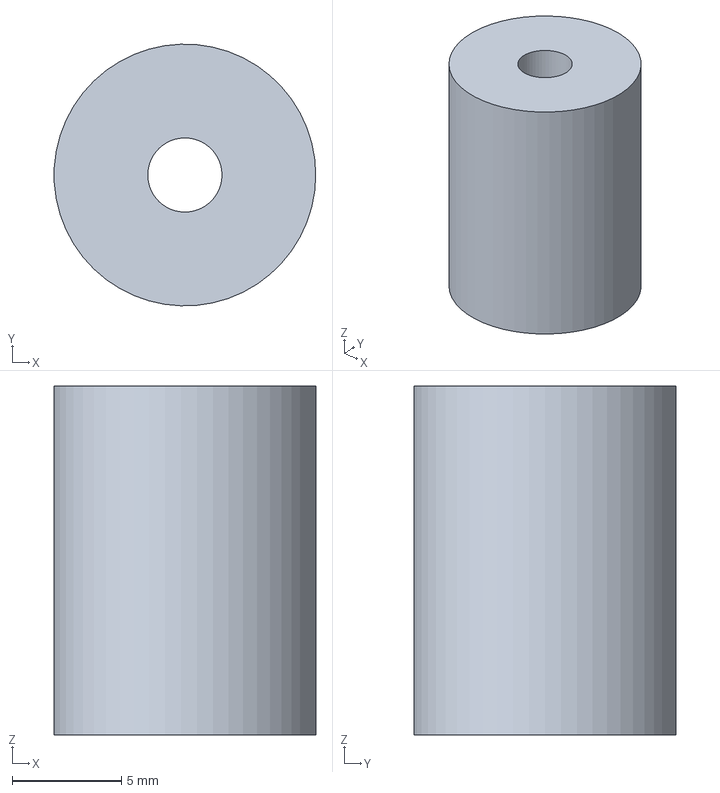
[picture p41: CAD file, 2026-10-19]
Parts/05_Bed/STEP/07_bed_spacer_16mm_print_4.step
12.0 x 12.0 x 16.0 mm
