BrandenConnors/it-dept-pumpkin-cart/Parts/06_Hood_Fenders/STEP/04_fender_pad_print_2_HF2.step

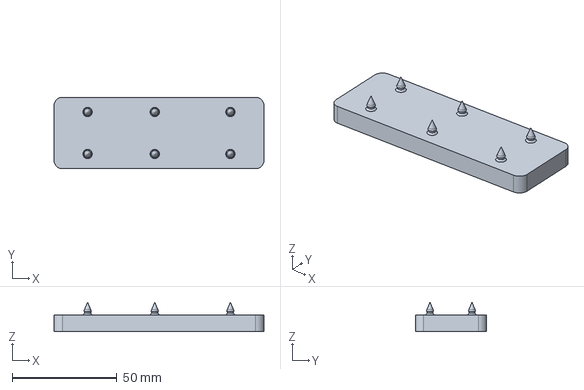
[picture p42: CAD file, 2026-10-19]
Parts/06_Hood_Fenders/STEP/04_fender_pad_print_2_HF2.step
100.0 x 34.0 x 14.0 mm
