BrandenConnors/it-dept-pumpkin-cart/Parts/07_Side_Runners/STEP/05_rear_bed_hanger_left.step

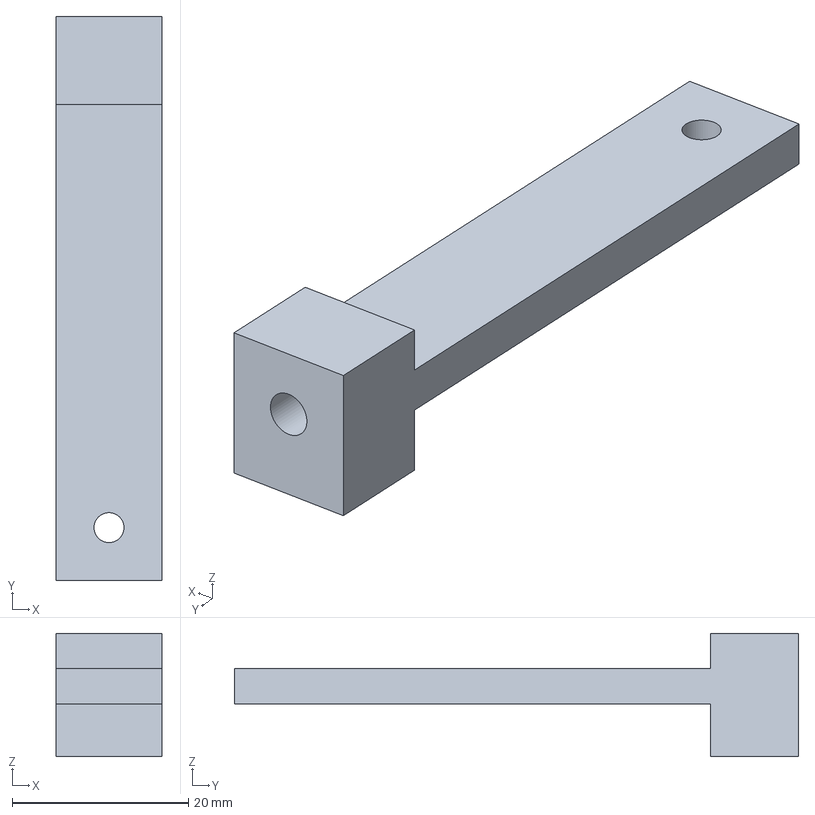
[picture p43: CAD file, 2026-10-19]
Parts/07_Side_Runners/STEP/05_rear_bed_hanger_left.step
12.0 x 64.0 x 14.0 mm
