BrandenConnors/it-dept-pumpkin-cart/Parts/08_Bumpers_Lights_Plaques/STL/18_5mm_LED_bezel_print_2.stl

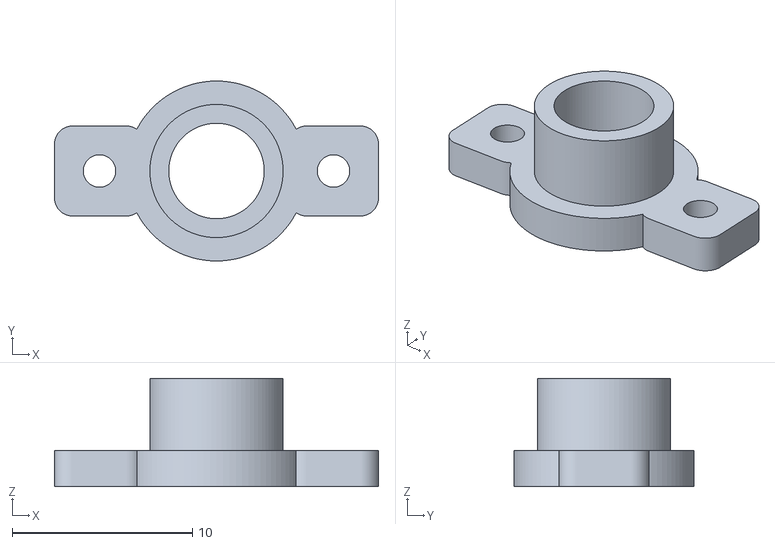
[picture p44: CAD file, 2026-10-19]
Parts/08_Bumpers_Lights_Plaques/STL/18_5mm_LED_bezel_print_2.stl
18.0 x 10.0 x 6.00
