BrandenConnors/it-dept-pumpkin-cart/Parts/09_Optional_Cargo/STL/04_dome_camera.stl

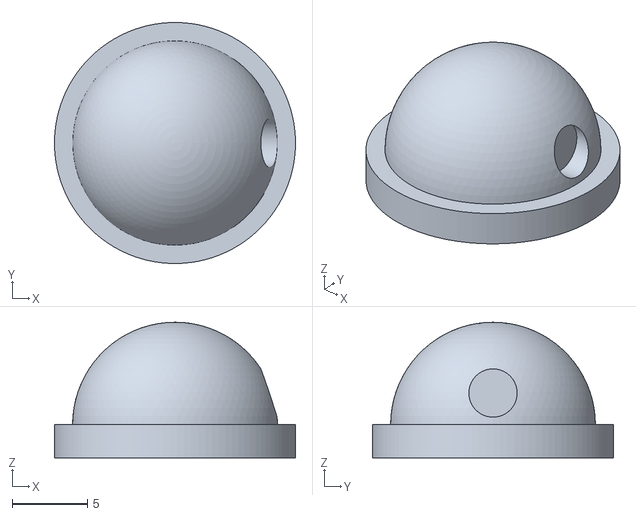
[picture p45: CAD file, 2026-10-19]
Parts/09_Optional_Cargo/STL/04_dome_camera.stl
16.0 x 16.0 x 9.00
