BrandenConnors/it-dept-pumpkin-cart/Parts/10_Fit_Tests/STEP/00_alignment_gauge_optional_HF2.step

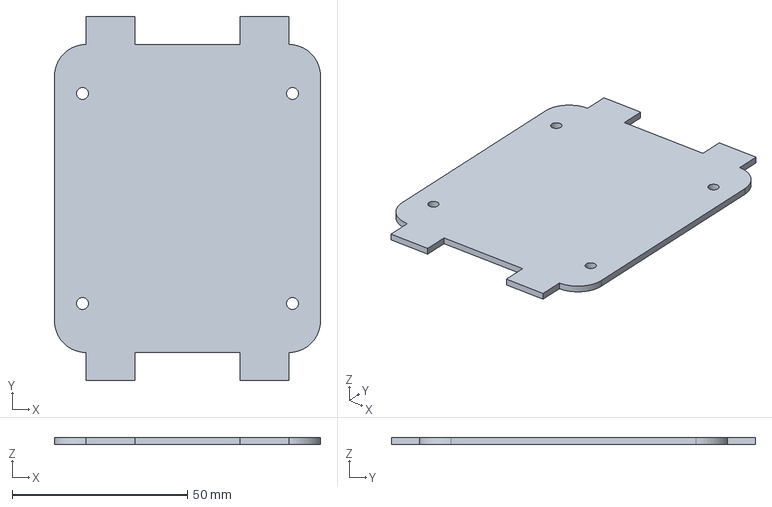
[picture p46: CAD file, 2026-10-19]
Parts/10_Fit_Tests/STEP/00_alignment_gauge_optional_HF2.step
76.0 x 104.0 x 2.00 mm
