BrandenConnors/it-dept-pumpkin-cart/Parts/01_Frame/STL/03_floor_splice_print_4.stl

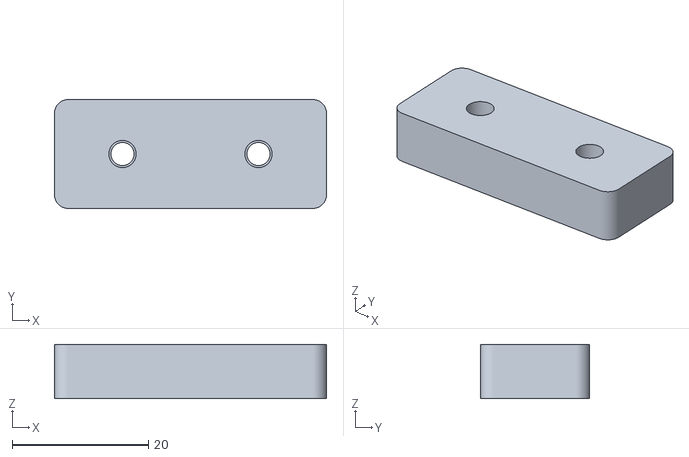
[picture p48: CAD file, 2026-10-19]
Parts/01_Frame/STL/03_floor_splice_print_4.stl
40.0 x 16.0 x 8.00
