BrandenConnors/it-dept-pumpkin-cart/Parts/03_Cab_Seat_Dashboard/STL/07_bench_seat.stl

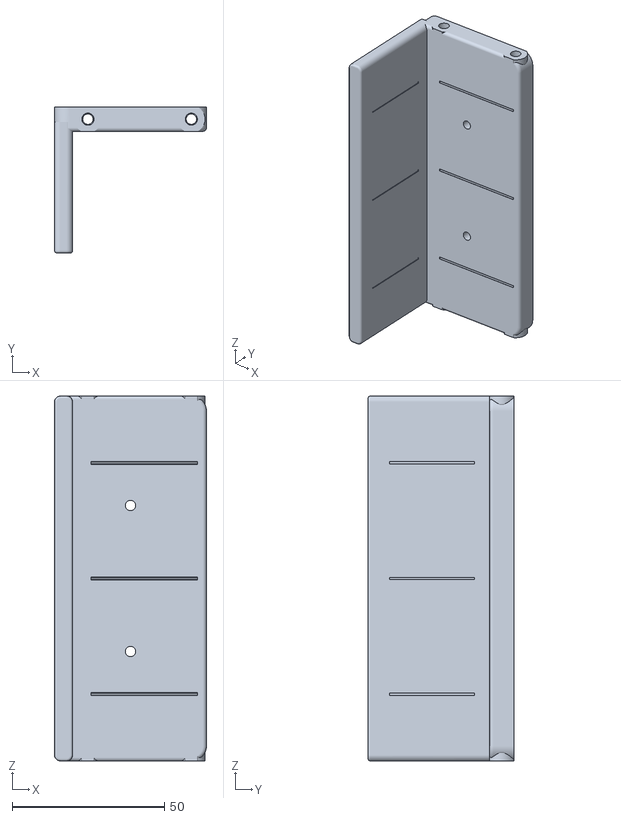
[picture p50: CAD file, 2026-10-19]
Parts/03_Cab_Seat_Dashboard/STL/07_bench_seat.stl
50.0 x 48.0 x 120.0
