BrandenConnors/it-dept-pumpkin-cart/Parts/04_Roof_Windshield/STL/21_windshield_plate_print_4.stl

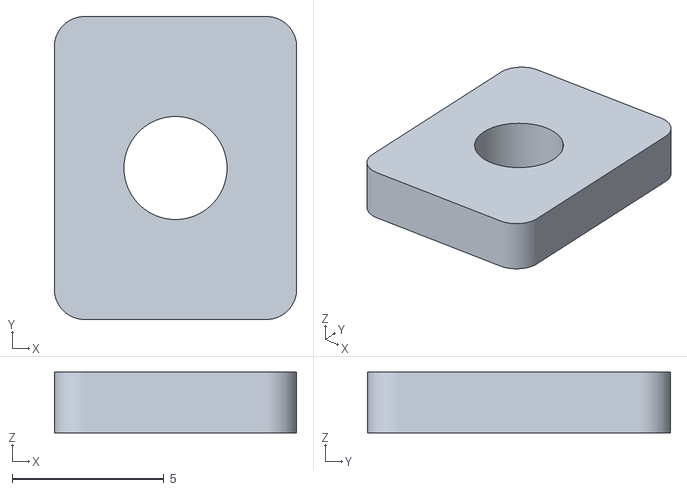
[picture p51: CAD file, 2026-10-19]
Parts/04_Roof_Windshield/STL/21_windshield_plate_print_4.stl
8.00 x 10.0 x 2.00
