BrandenConnors/it-dept-pumpkin-cart/Parts/07_Side_Runners/STEP/06_forward_bed_hanger_left.step

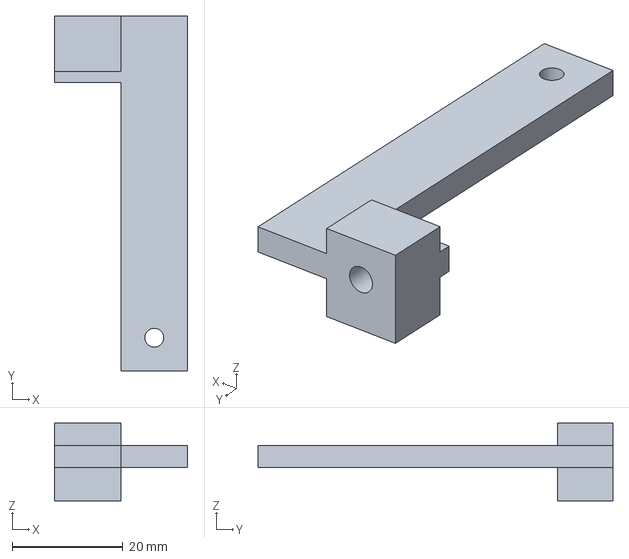
[picture p52: CAD file, 2026-10-19]
Parts/07_Side_Runners/STEP/06_forward_bed_hanger_left.step
24.0 x 64.0 x 14.0 mm
