BrandenConnors/it-dept-pumpkin-cart/Parts/08_Bumpers_Lights_Plaques/STL/20B_rear_bumper_adjustable.stl

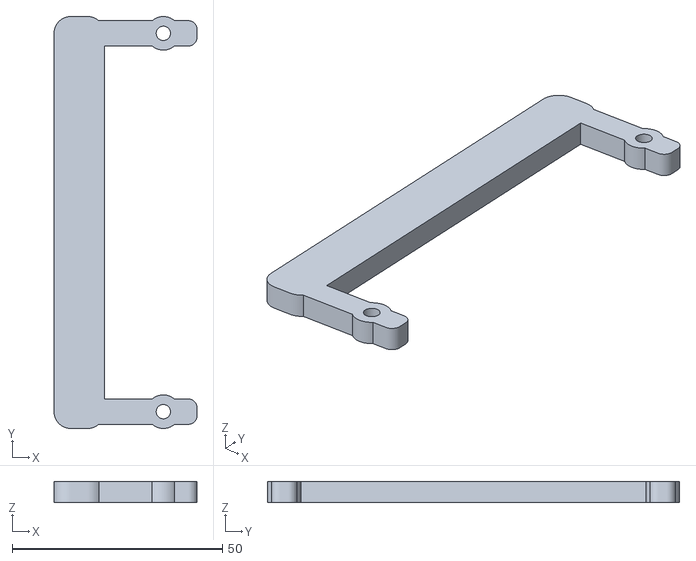
[picture p53: CAD file, 2026-10-19]
Parts/08_Bumpers_Lights_Plaques/STL/20B_rear_bumper_adjustable.stl
34.0 x 98.0 x 5.00
