BrandenConnors/it-dept-pumpkin-cart/Parts/09_Optional_Cargo/STL/05_toolbox_body.stl

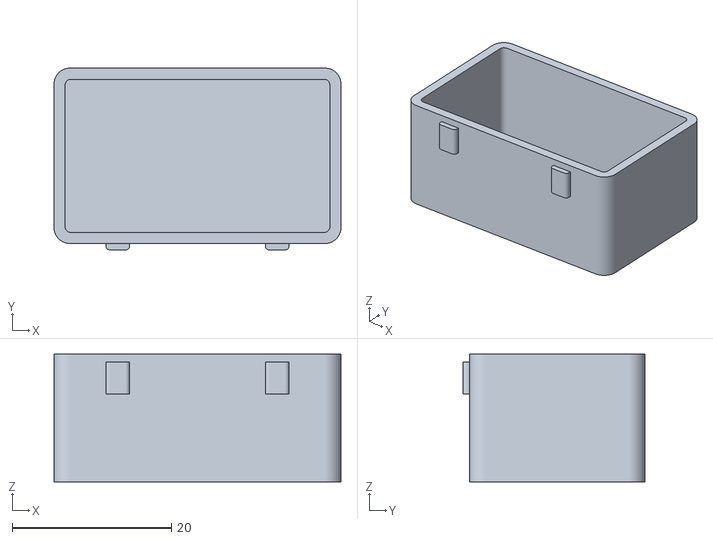
[picture p54: CAD file, 2026-10-19]
Parts/09_Optional_Cargo/STL/05_toolbox_body.stl
36.0 x 22.8 x 16.0
