BrandenConnors/it-dept-pumpkin-cart/Parts/10_Fit_Tests/STL/00_fit_coupon.stl

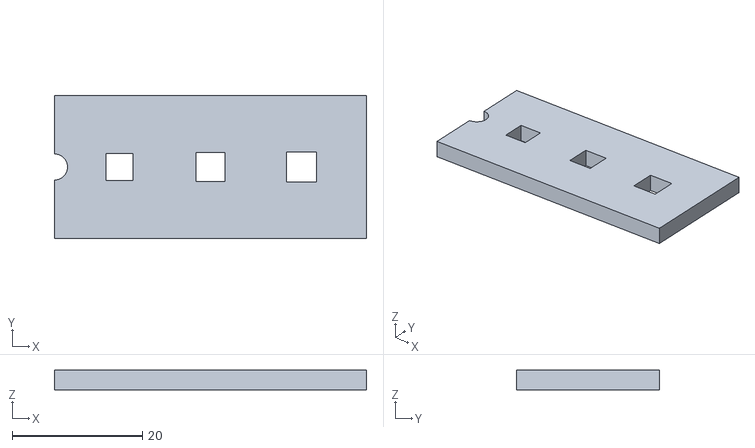
[picture p55: CAD file, 2026-10-19]
Parts/10_Fit_Tests/STL/00_fit_coupon.stl
48.0 x 22.0 x 3.00
