BrandenConnors/it-dept-pumpkin-cart/Parts/02_Chassis_Mounts/STL/17B_mount_shim_2mm_OPTIONAL.stl

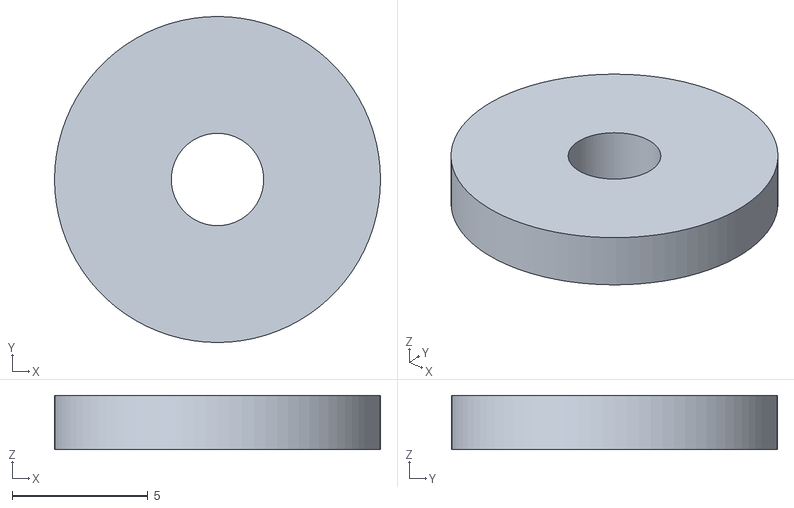
[picture p56: CAD file, 2026-10-19]
Parts/02_Chassis_Mounts/STL/17B_mount_shim_2mm_OPTIONAL.stl
12.0 x 12.0 x 2.00
