BrandenConnors/it-dept-pumpkin-cart/Parts/03_Cab_Seat_Dashboard/STL/13_steering_wheel_and_column.stl

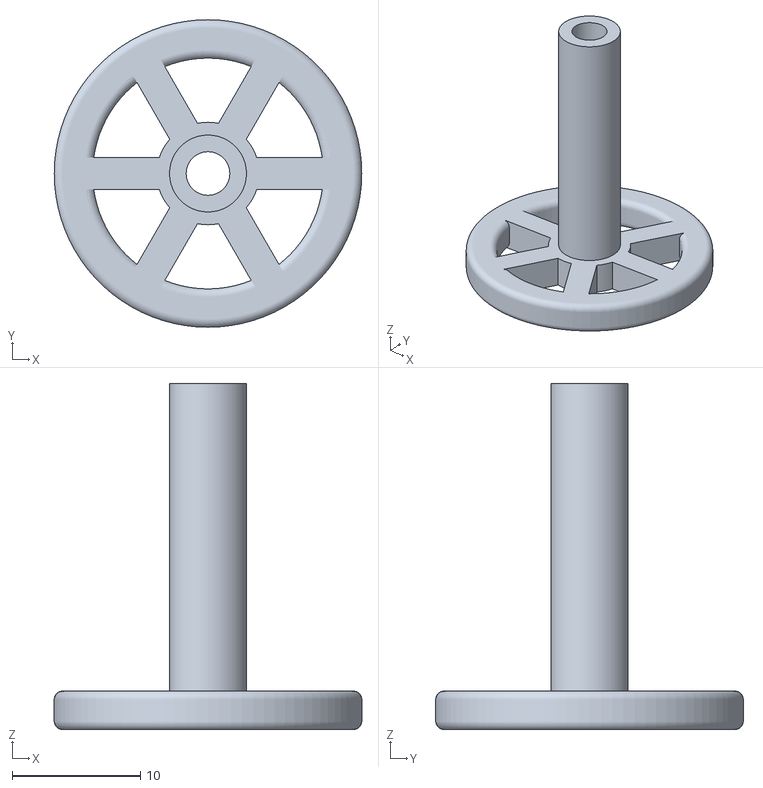
[picture p57: CAD file, 2026-10-19]
Parts/03_Cab_Seat_Dashboard/STL/13_steering_wheel_and_column.stl
24.0 x 24.0 x 27.0
