BrandenConnors/it-dept-pumpkin-cart/Parts/06_Hood_Fenders/STEP/05_raised_spike_bar_print_2_HF2.step

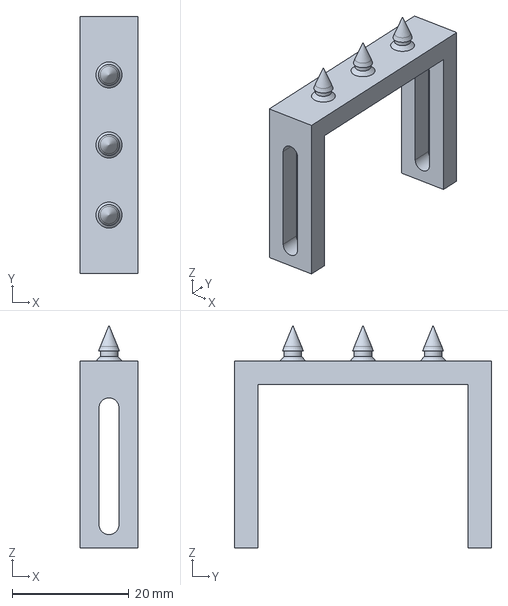
[picture p58: CAD file, 2026-10-19]
Parts/06_Hood_Fenders/STEP/05_raised_spike_bar_print_2_HF2.step
10.0 x 44.0 x 38.0 mm
