BrandenConnors/it-dept-pumpkin-cart/Parts/08_Bumpers_Lights_Plaques/STL/19_IT_DEPT_plaque_print_2.stl

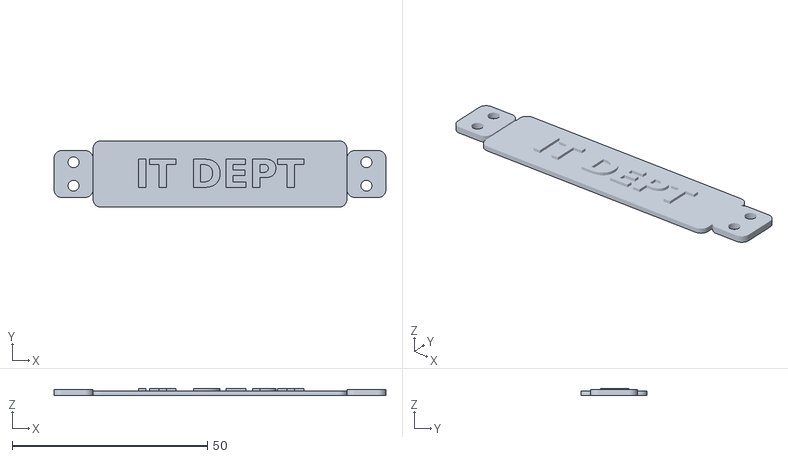
[picture p59: CAD file, 2026-10-19]
Parts/08_Bumpers_Lights_Plaques/STL/19_IT_DEPT_plaque_print_2.stl
85.0 x 17.0 x 1.90
