BrandenConnors/it-dept-pumpkin-cart/Parts/09_Optional_Cargo/STL/06_cable_coil.stl

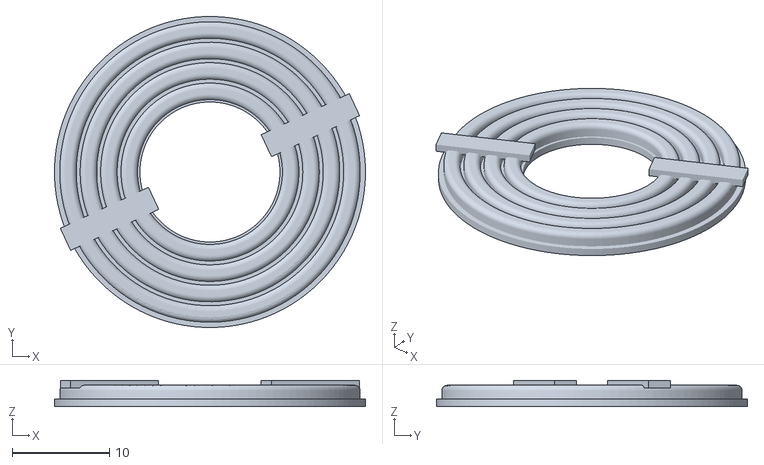
[picture p60: CAD file, 2026-10-19]
Parts/09_Optional_Cargo/STL/06_cable_coil.stl
32.0 x 32.0 x 2.70
