BrandenConnors/it-dept-pumpkin-cart/Parts/10_Fit_Tests/STL/00b_fit_peg.stl

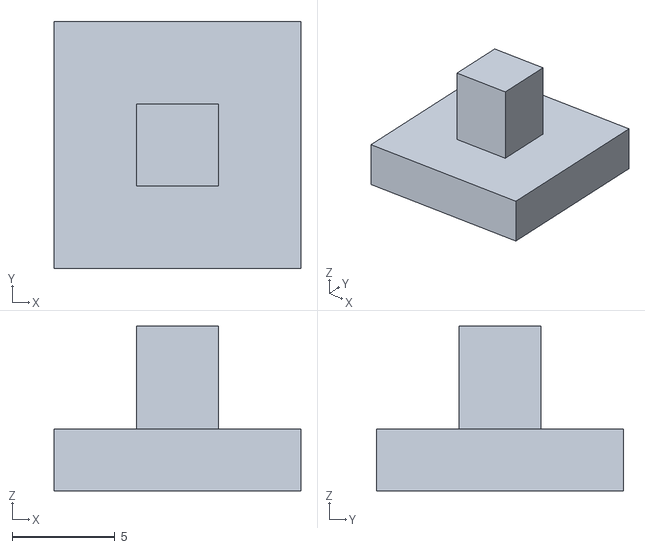
[picture p61: CAD file, 2026-10-19]
Parts/10_Fit_Tests/STL/00b_fit_peg.stl
12.0 x 12.0 x 8.00
