BrandenConnors/it-dept-pumpkin-cart/Parts/03_Cab_Seat_Dashboard/STL/08_armrest_print_2.stl

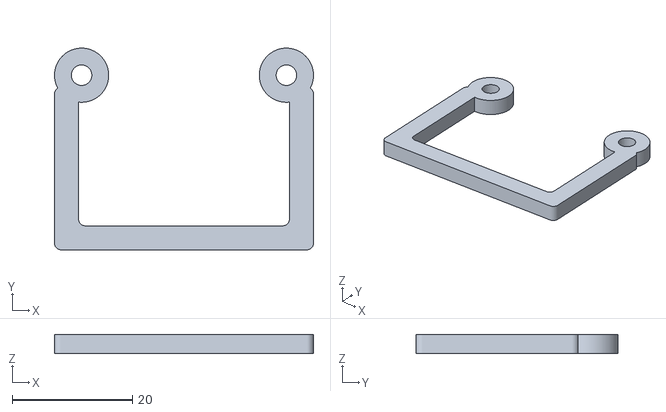
[picture p62: CAD file, 2026-10-19]
Parts/03_Cab_Seat_Dashboard/STL/08_armrest_print_2.stl
43.0 x 33.5 x 3.20
