BrandenConnors/it-dept-pumpkin-cart/Parts/06_Hood_Fenders/STEP/01_spiked_hood_carrier_HF2.step

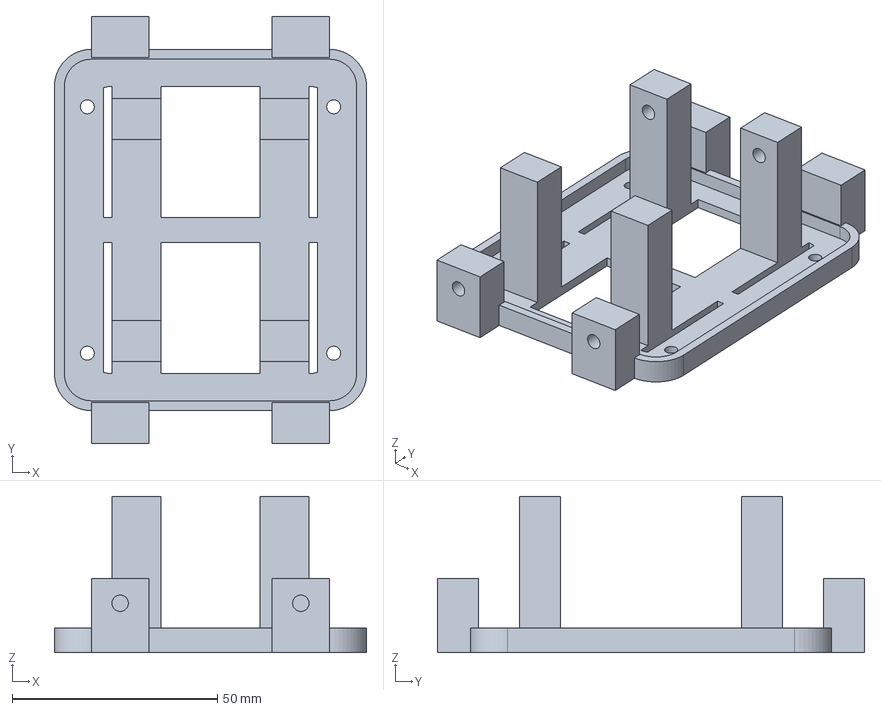
[picture p63: CAD file, 2026-10-19]
Parts/06_Hood_Fenders/STEP/01_spiked_hood_carrier_HF2.step
76.0 x 104.0 x 38.0 mm
