BrandenConnors/it-dept-pumpkin-cart/Parts/07_Side_Runners/STEP/01_cab_skirt_right.step

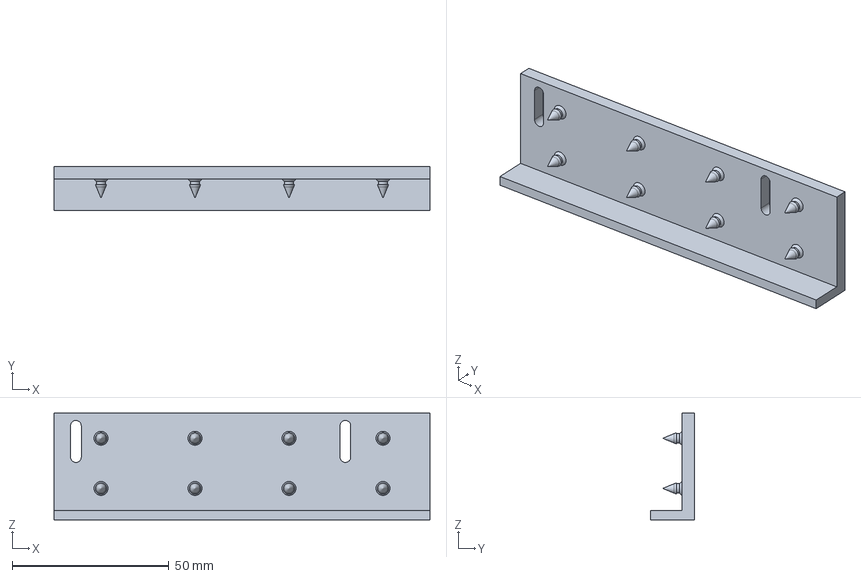
[picture p64: CAD file, 2026-10-19]
Parts/07_Side_Runners/STEP/01_cab_skirt_right.step
120.0 x 14.0 x 34.0 mm
