BrandenConnors/it-dept-pumpkin-cart/Parts/08_Bumpers_Lights_Plaques/STL/20C_rear_bumper_insert_block_print_2.stl

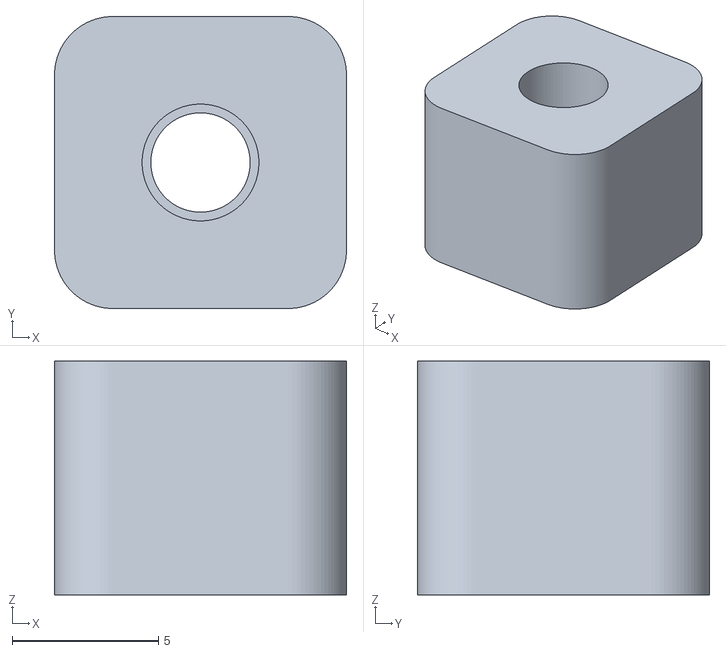
[picture p65: CAD file, 2026-10-19]
Parts/08_Bumpers_Lights_Plaques/STL/20C_rear_bumper_insert_block_print_2.stl
10.0 x 10.0 x 8.00
