BrandenConnors/it-dept-pumpkin-cart/Parts/09_Optional_Cargo/STL/07_pc_tower_body.stl

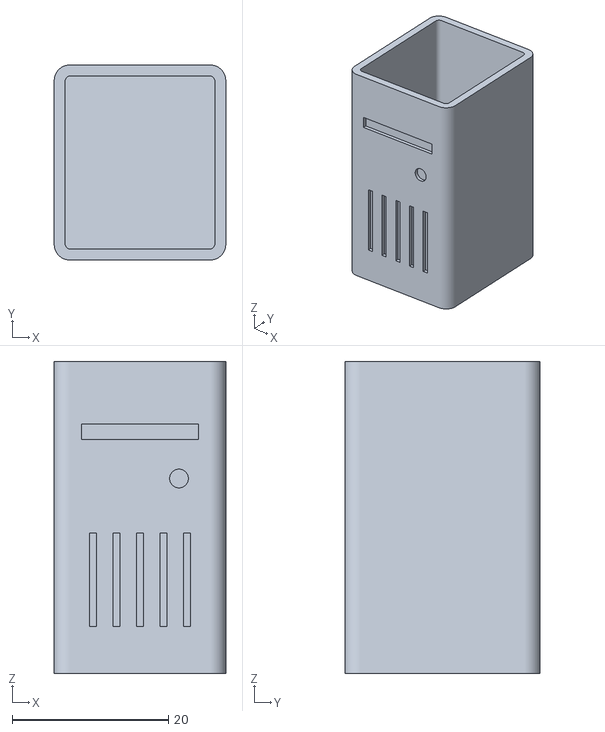
[picture p66: CAD file, 2026-10-19]
Parts/09_Optional_Cargo/STL/07_pc_tower_body.stl
22.0 x 25.0 x 40.0
