BrandenConnors/it-dept-pumpkin-cart/Parts/10_Fit_Tests/STL/00C_front_mount_TEMPLATE_2mm.stl

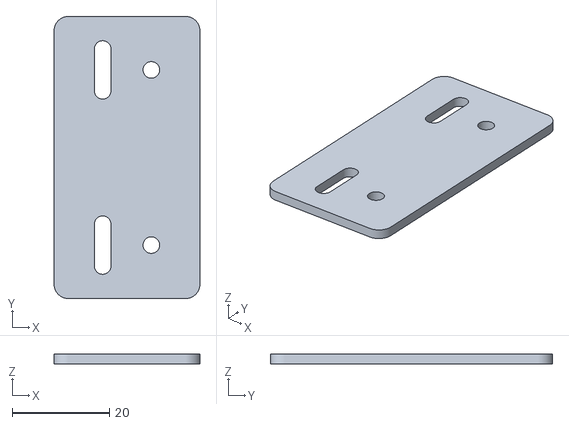
[picture p67: CAD file, 2026-10-19]
Parts/10_Fit_Tests/STL/00C_front_mount_TEMPLATE_2mm.stl
30.0 x 58.0 x 2.00
