BrandenConnors/it-dept-pumpkin-cart/Parts/09_Optional_Cargo/STL/05_toolbox_lid.stl

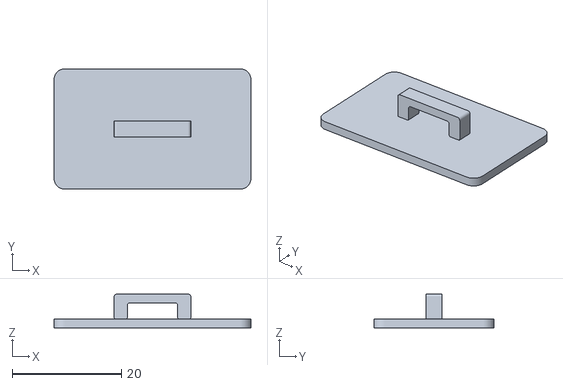
[picture p68: CAD file, 2026-10-19]
Parts/09_Optional_Cargo/STL/05_toolbox_lid.stl
36.0 x 22.0 x 6.20
