BrandenConnors/it-dept-pumpkin-cart/Parts/07_Side_Runners/STEP/09_offset_spacer_10mm_optional.step

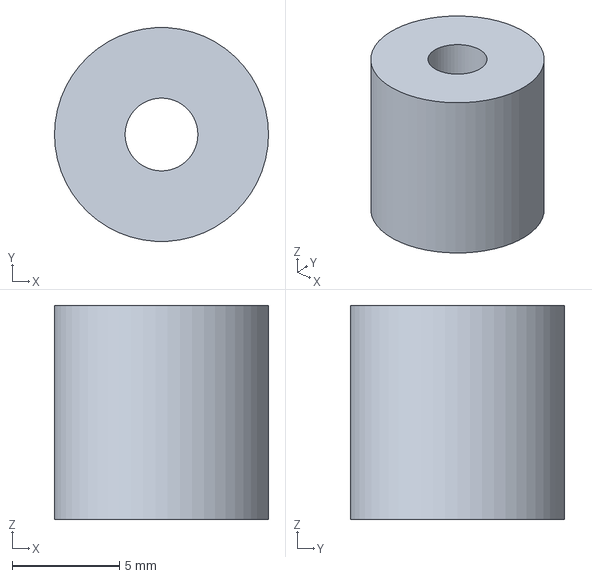
[picture p69: CAD file, 2026-10-19]
Parts/07_Side_Runners/STEP/09_offset_spacer_10mm_optional.step
10.0 x 9.98 x 10.0 mm
