BrandenConnors/it-dept-pumpkin-cart/Parts/09_Optional_Cargo/STL/02_switch_8port_body.stl

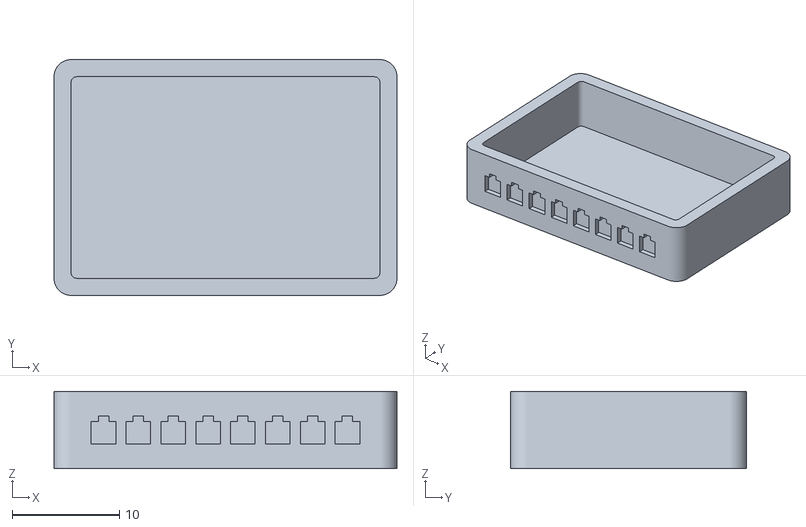
[picture p70: CAD file, 2026-10-19]
Parts/09_Optional_Cargo/STL/02_switch_8port_body.stl
32.0 x 22.0 x 7.20
