BrandenConnors/it-dept-pumpkin-cart/Parts/07_Side_Runners/STEP/08_offset_spacer_5mm_optional.step

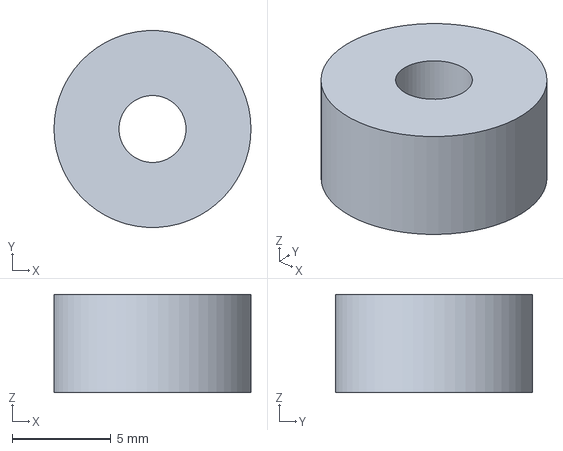
[picture p72: CAD file, 2026-10-19]
Parts/07_Side_Runners/STEP/08_offset_spacer_5mm_optional.step
10.0 x 9.99 x 5.00 mm
