BrandenConnors/it-dept-pumpkin-cart/Parts/09_Optional_Cargo/STL/01_switch_24port_body.stl

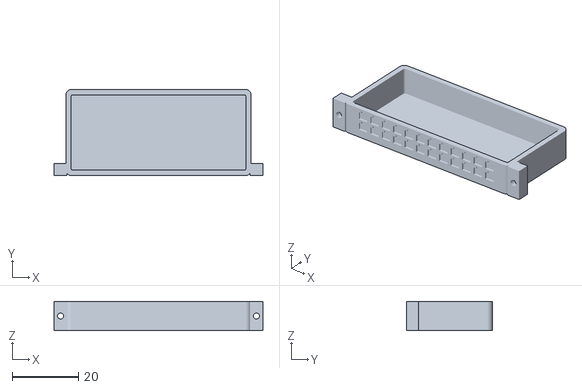
[picture p73: CAD file, 2026-10-19]
Parts/09_Optional_Cargo/STL/01_switch_24port_body.stl
63.2 x 26.0 x 8.80
