BrandenConnors/it-dept-pumpkin-cart/Parts/07_Side_Runners/STEP/04_cab_lower_jaw_right.step

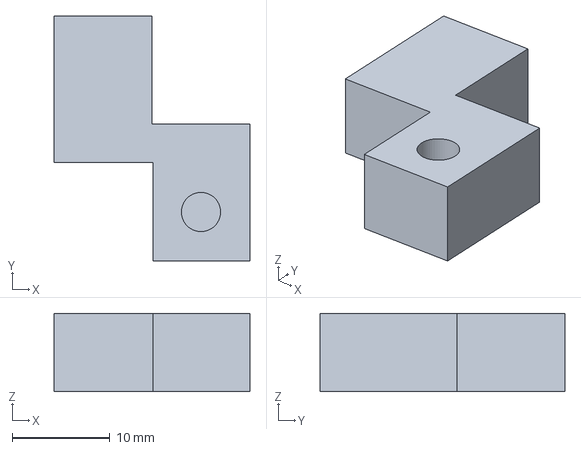
[picture p74: CAD file, 2026-10-19]
Parts/07_Side_Runners/STEP/04_cab_lower_jaw_right.step
20.0 x 25.0 x 8.00 mm
