BrandenConnors/it-dept-pumpkin-cart/Parts/09_Optional_Cargo/STL/03_bullet_camera.stl

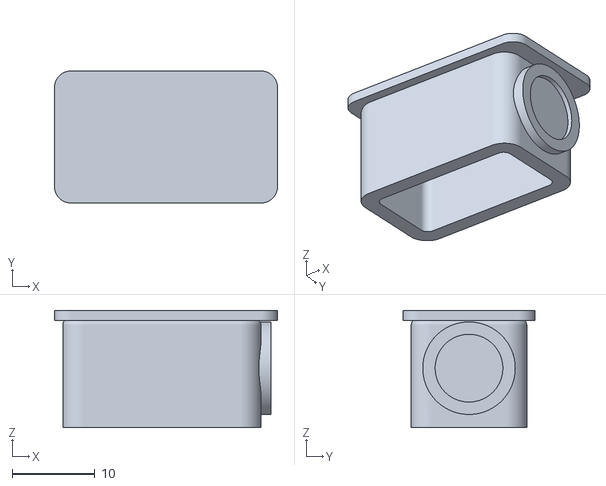
[picture p75: CAD file, 2026-10-19]
Parts/09_Optional_Cargo/STL/03_bullet_camera.stl
27.0 x 16.0 x 14.2
