BrandenConnors/it-dept-pumpkin-cart/Parts/09_Optional_Cargo/STL/01_switch_24port_lid.stl

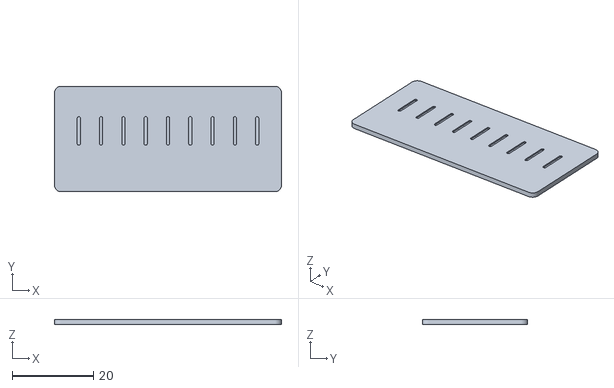
[picture p76: CAD file, 2026-10-19]
Parts/09_Optional_Cargo/STL/01_switch_24port_lid.stl
56.0 x 26.0 x 1.20
