BrandenConnors/it-dept-pumpkin-cart/Parts/07_Side_Runners/STEP/02_rear_arch_right.step

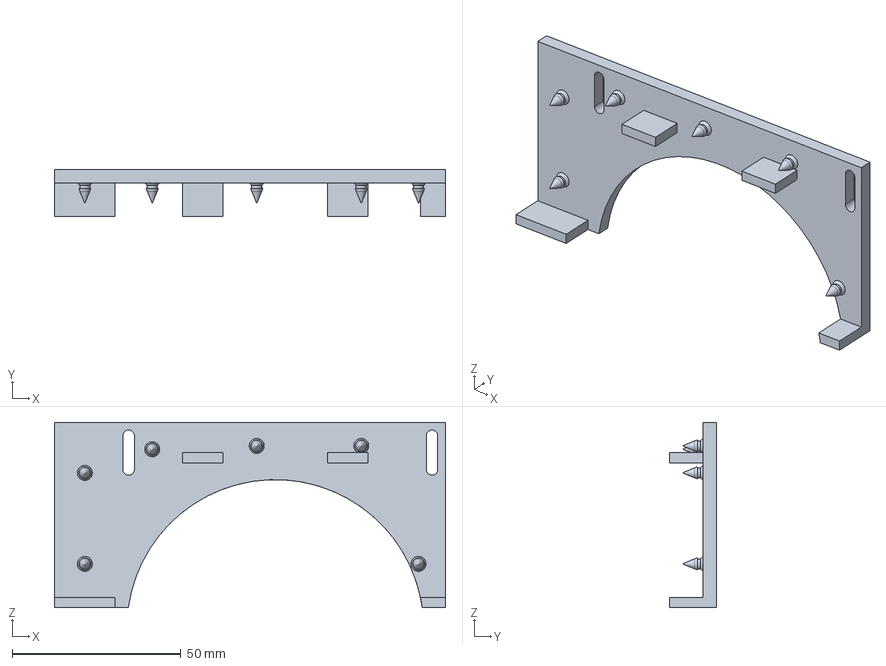
[picture p77: CAD file, 2026-10-19]
Parts/07_Side_Runners/STEP/02_rear_arch_right.step
116.0 x 14.0 x 55.0 mm
