BrandenConnors/it-dept-pumpkin-cart/(list of files, cad)

Other CAD files:
Parts/06_Hood_Fenders/STEP/02_fender_riser_positive_Y_HF2.step
Parts/07_Side_Runners/STEP/06_forward_bed_hanger_right.step
Parts/07_Side_Runners/STEP/05_rear_bed_hanger_right.step
Parts/07_Side_Runners/STEP/01_cab_skirt_left.step
Parts/07_Side_Runners/STEP/03_cab_upper_clamp_left.step
Parts/07_Side_Runners/STEP/04_cab_lower_jaw_left.step
Parts/07_Side_Runners/STEP/02_rear_arch_left.step
Parts/04_Roof_Windshield/STL/11_roof_sharp_6mm_R2.stl
Parts/05_Bed/STL/04_bed_50mm_sharp_6mm_R2.stl
Parts/05_Bed/STL/07_bed_spacer_16mm_print_4.stl
Parts/06_Hood_Fenders/STL/01_spiked_hood_carrier_HF2.stl
Parts/06_Hood_Fenders/STL/02_fender_riser_positive_Y_HF2.stl
Parts/06_Hood_Fenders/STL/03_fender_riser_negative_Y_HF2.stl
Parts/06_Hood_Fenders/STL/04_fender_pad_print_2_HF2.stl
Parts/06_Hood_Fenders/STL/05_raised_spike_bar_print_2_HF2.stl
Parts/07_Side_Runners/STL/01_cab_skirt_left.stl
Parts/07_Side_Runners/STL/01_cab_skirt_right.stl
Parts/07_Side_Runners/STL/02_rear_arch_left.stl
Parts/07_Side_Runners/STL/02_rear_arch_right.stl
Parts/07_Side_Runners/STL/03_cab_upper_clamp_left.stl
Parts/07_Side_Runners/STL/03_cab_upper_clamp_right.stl
Parts/07_Side_Runners/STL/04_cab_lower_jaw_left.stl
Parts/07_Side_Runners/STL/04_cab_lower_jaw_right.stl
Parts/07_Side_Runners/STL/05_rear_bed_hanger_left.stl
Parts/07_Side_Runners/STL/05_rear_bed_hanger_right.stl
Parts/07_Side_Runners/STL/06_forward_bed_hanger_left.stl
Parts/07_Side_Runners/STL/06_forward_bed_hanger_right.stl
Parts/07_Side_Runners/STL/08_offset_spacer_5mm_optional.stl
Parts/07_Side_Runners/STL/09_offset_spacer_10mm_optional.stl
Parts/10_Fit_Tests/STL/00_alignment_gauge_optional_HF2.stl
Parts/10_Fit_Tests/STL/00_sharp_peg_test_strip_R2.stl
