BrandenConnors/it-dept-pumpkin-cart/Parts/01_Frame/Flat_Floor_Print_Orientation.png

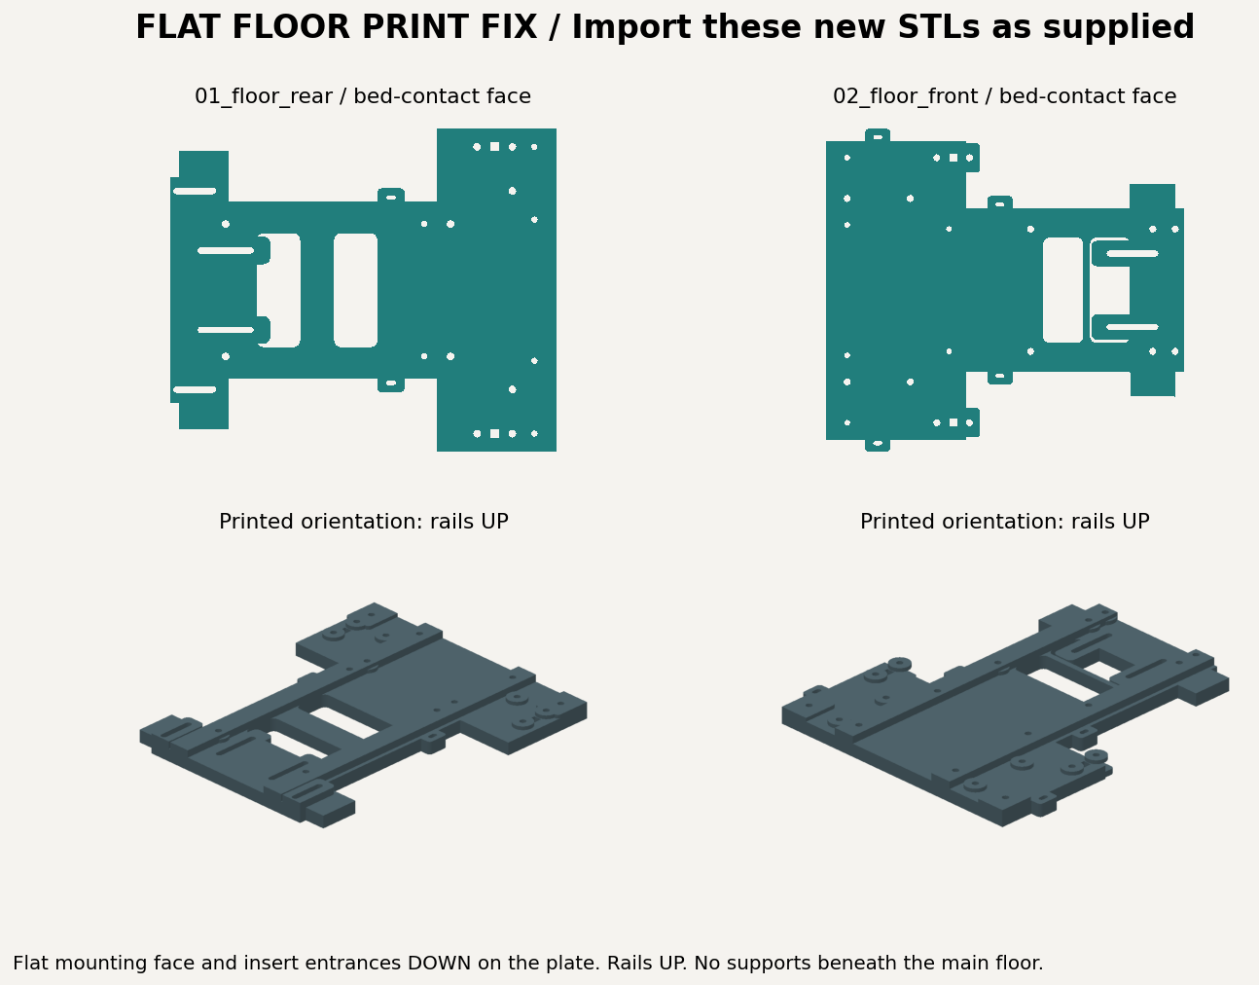
Parts/01_Frame/Flat_Floor_Print_Orientation.png
