BrandenConnors/it-dept-pumpkin-cart/Parts/10_Fit_Tests/README.md

# 10 Fit Tests

Use the master [build guide](../../Documentation/Build_Guide.pdf). STL files use millimeters and retain their supplied print orientations. One STL is one piece; print the quantities below.

| STL | Quantity | Status |
|---|---:|---|
| 00C_front_mount_TEMPLATE_2mm.stl | 1 | Optional test |
| 00D_rear_mount_TEMPLATE_2mm.stl | 1 | Optional test |
| 00_fit_coupon.stl | 1 | Optional test |
| 00b_fit_peg.stl | 1 | Optional test |
| 00E_M3_insert_fit_test.stl | 1 | Optional test |
| 00_sharp_peg_test_strip_R2.stl | 1 | Optional test |
| 00_alignment_gauge_optional_HF2.stl | 1 | Optional test |

## Fit and printing notes

- **00C_front_mount_TEMPLATE_2mm.stl:** PRINT FIRST. Thin fit template ONLY, never use to carry the cart. Chassis holes are the slotted row; round holes belong to floor bolts.
- **00D_rear_mount_TEMPLATE_2mm.stl:** PRINT FIRST. Thin fit template ONLY, never use to carry the cart. Chassis holes are the slotted row; round holes belong to floor bolts.
- **00_fit_coupon.stl:** Print FIRST with 00b: slots from notched end are 4.2/4.4/4.6 mm
- **00b_fit_peg.stl:** Print FIRST with 00: use this separate 4.0 mm peg to test the slots
- **00E_M3_insert_fit_test.stl:** Test 4.0 mm first. Pockets 3.8 to 4.8 mm, depth 6.7, for assumed 5.7 mm insert. Choose secure fit without bulging; measure longer/larger inserts before use.
