BrandenConnors/it-dept-pumpkin-cart/Documentation/RELEASE_NOTES.md

# Release 1.0.0 — 2026-10-19

## Assembly status

Branden reported: “this all fit and is assembled.” The current combined design is recorded as user-confirmed assembly fit. No new physical test of pumpkin grip or loaded running was reported with that statement.

## Packaging changes

- Consolidated flat v06 floors, R2 bed/roof, HF2 hood/fenders, SR1 side runners and optional cargo into one release.
- Grouped STL/available STEP files by physical system with quantities and notes.
- Included the unchanged 37-page master guide, insert maps and combined hardware list.
- Consolidated current cutting stencils; removed the obsolete low-hood template and added front-fender contact patterns / HF2 fitting reference.
- Added README, source documentation, GitHub publication plan, file inventory and SHA-256 checksums.
- No printable geometry or successful print orientation changed in this packaging release.

Older caution labels in the build guide describe its pre-assembly publication state. This assembly report updates that status for Branden's build, without establishing a payload rating or fit on other chassis.
